witnessmenow/ESP32-Trinity/hardware/Add-Ons/Matrix Logic Level Shifter/README.md

An external add-on for logic level shifting the pins from the ESP32 to the Matrix. It is not Trinity specific and could be used with any matrix solution.

Potential solution for https://github.com/witnessmenow/ESP32-Trinity/issues/4
