witnessmenow/ESP32-Trinity/hardware/ESP32Trinity/V2.0 - Unreleased 4 layer version/README.md

**Untested!!**

This version is a 4 layer board that includes logic level shifters. I have ordered a PCB, but I have never actually assembled it so I'm unsure if it works.
