witnessmenow/ESP32-Trinity/userProjects.md

# User Projects

Made something with the Trinity? Why don't you share it here! Feel free to push a PR with your project added to this page, please just follow the template of the other projects.

## clockwise - By Jonathas Barbosa

Clockwise is a platform for creating animations with awesome clock animations

Mario jumping against coin block to change the time

The project is written with platform.io, so will require some experience with that to get it to run. Jonathas is working on a simpler version that uses the Arduino IDE so keep an eye out!

[Github](https://github.com/jnthas/clockwise)
