witnessmenow/ESP32-Trinity/documentation/Large Details Card/1.png

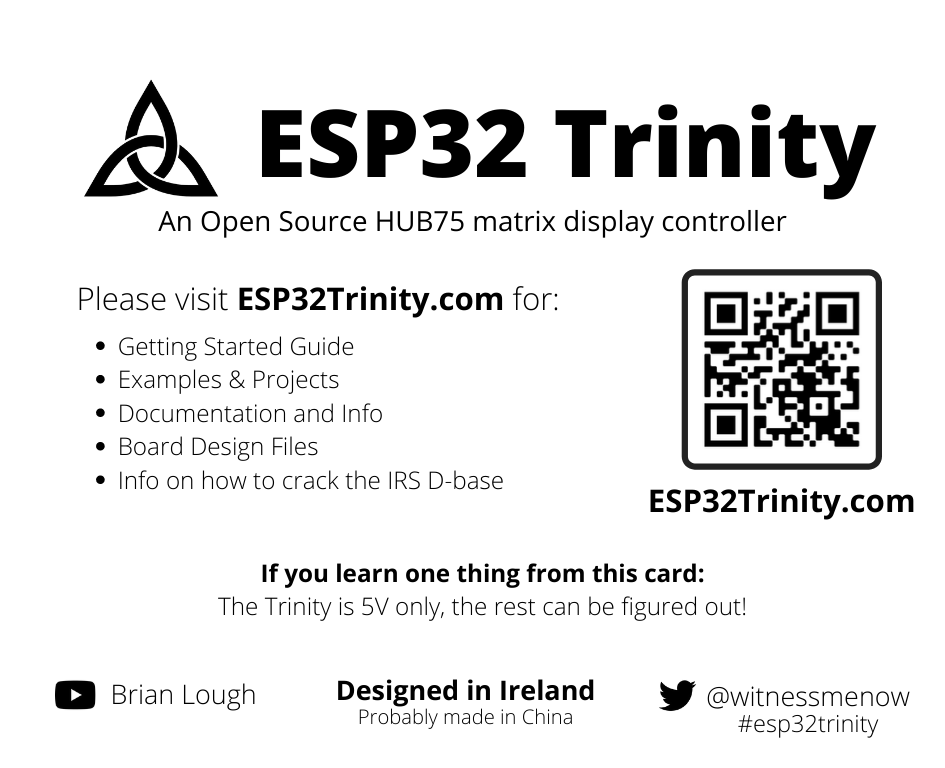
documentation/Large Details Card/1.png
