witnessmenow/ESP32-Trinity/documentation/Large Details Card/2.png

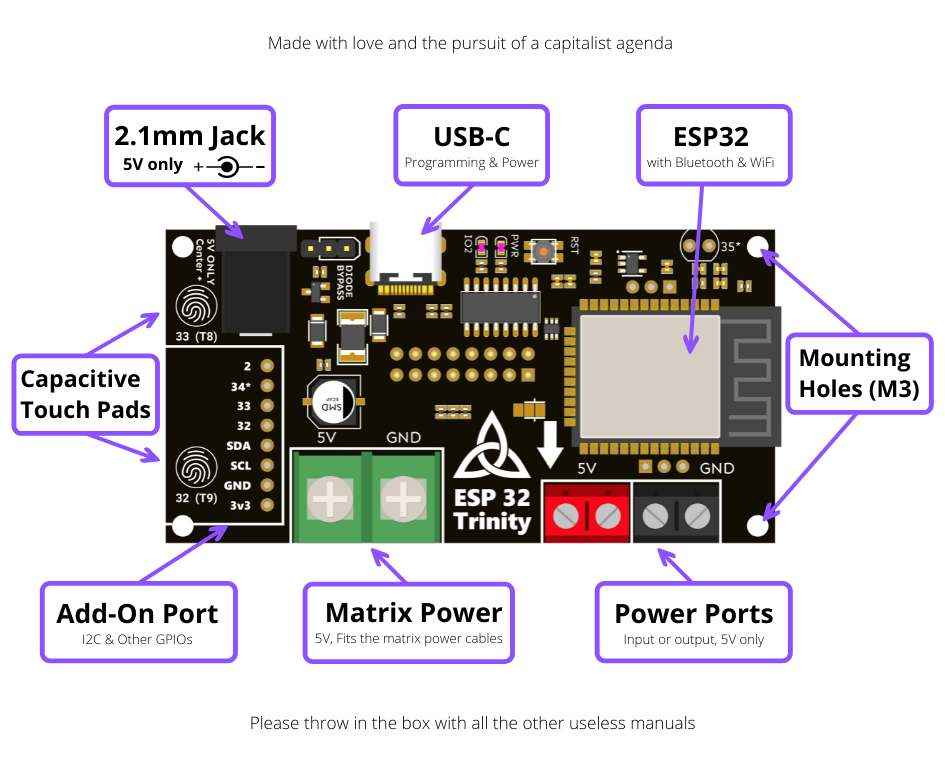
documentation/Large Details Card/2.png
