witnessmenow/ESP32-Trinity/documentation/Small Details Card/1.png

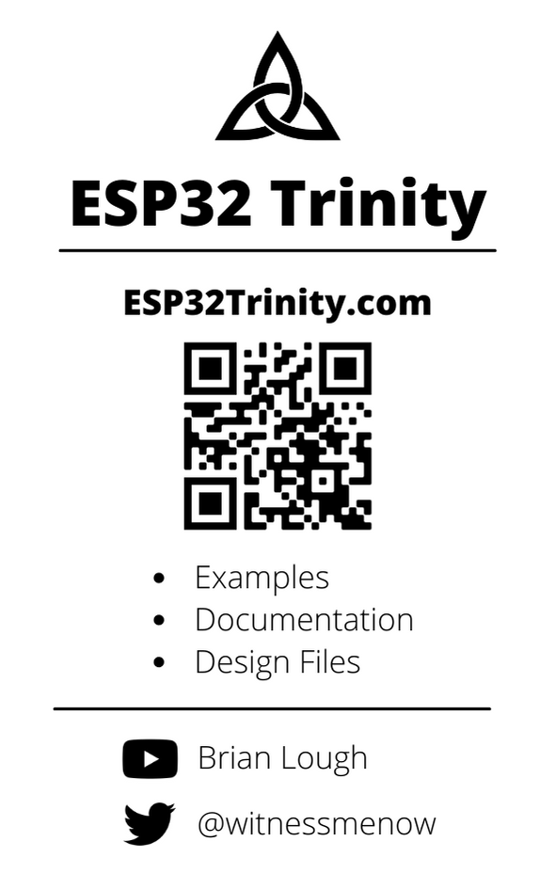
documentation/Small Details Card/1.png
