witnessmenow/ESP32-Trinity/documentation/Small Details Card/2.png

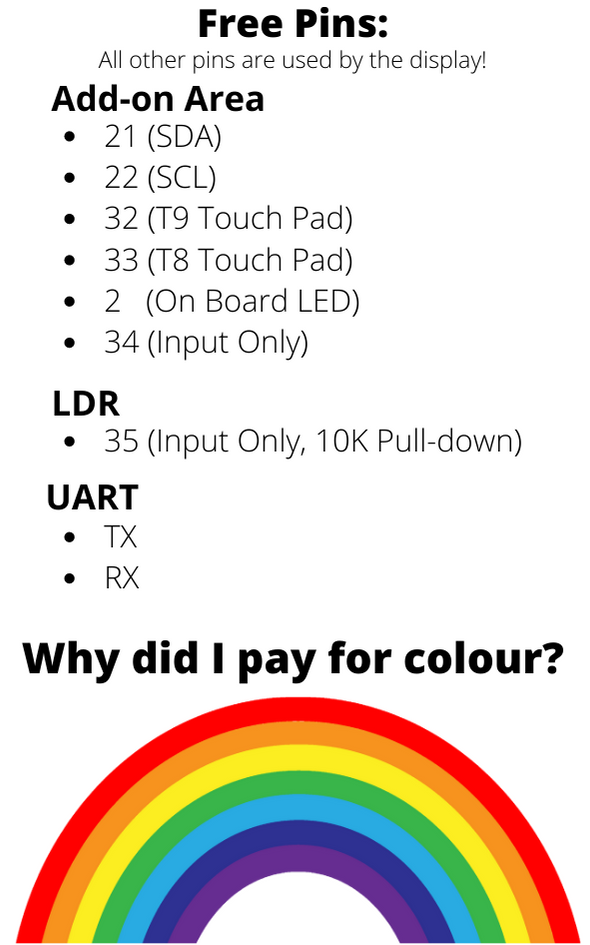
documentation/Small Details Card/2.png
