witnessmenow/ESP32-Trinity/hardware/Add-Ons/Add-on-Breakout/Schematic_Trinity Add-On-Breakout_2021-09-19.png

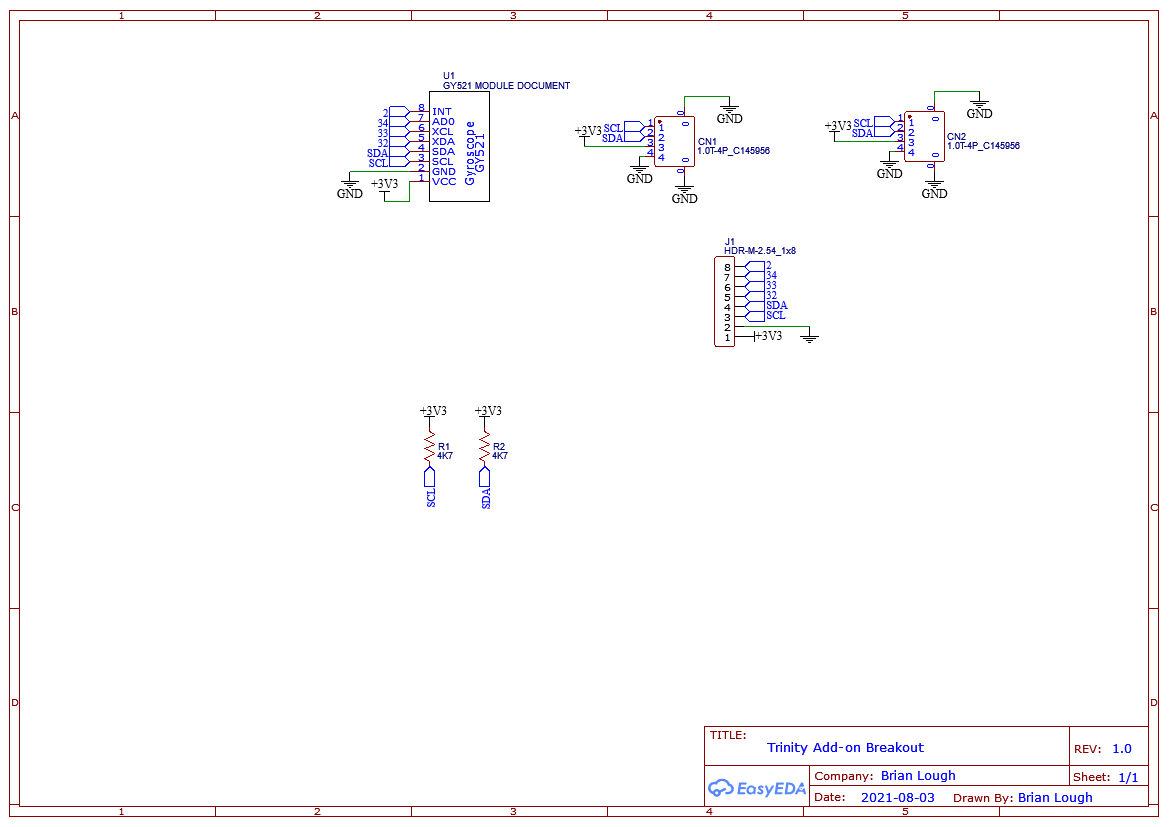
hardware/Add-Ons/Add-on-Breakout/Schematic_Trinity Add-On-Breakout_2021-09-19.png
