witnessmenow/ESP32-Trinity/hardware/Add-Ons/Matrix Logic Level Shifter/V1.0/Schematic_Hub75-Level-shifter_2024-02-03.png

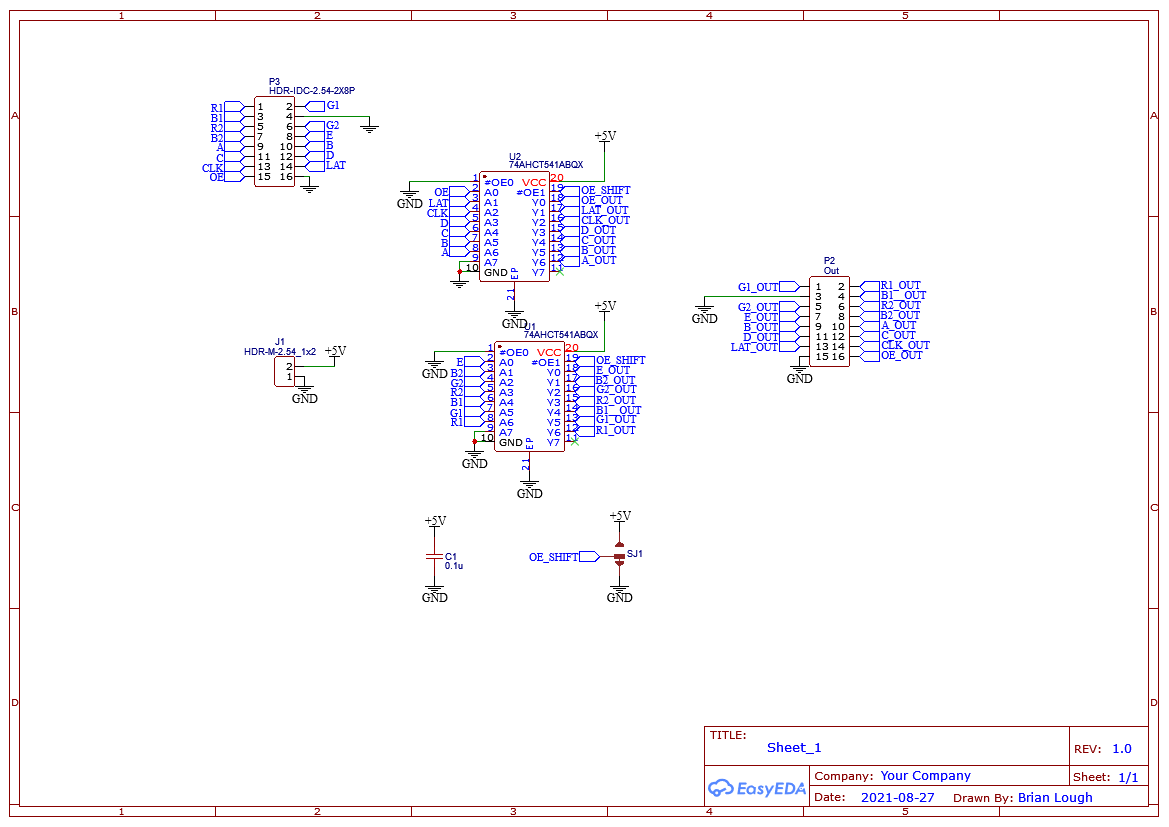
hardware/Add-Ons/Matrix Logic Level Shifter/V1.0/Schematic_Hub75-Level-shifter_2024-02-03.png
