witnessmenow/ESP32-Trinity/hardware/Add-Ons/MicroSd-board/Schematic_SD Card GY521_2021-09-19.png

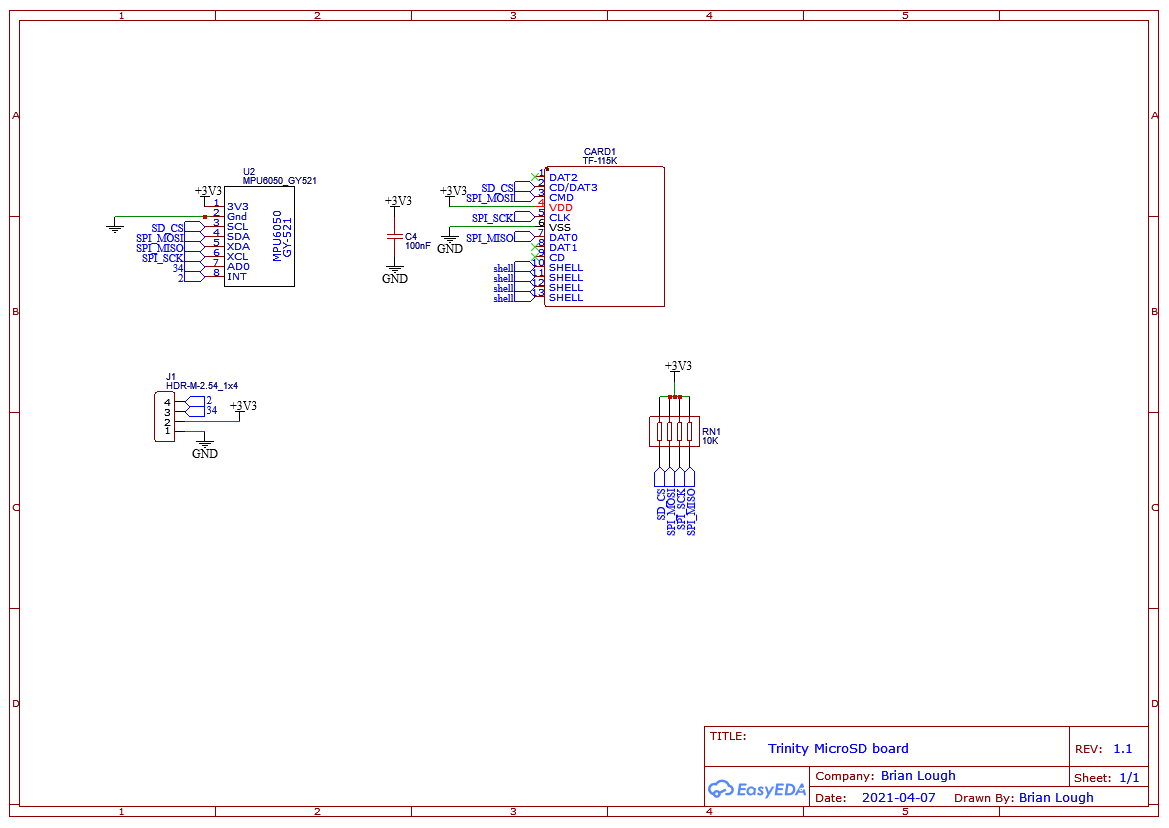
hardware/Add-Ons/MicroSd-board/Schematic_SD Card GY521_2021-09-19.png
