witnessmenow/ESP32-Trinity/hardware/Add-Ons/Nunchuck-board/Schematic_Nunchuck-MPU6050_2021-09-19.png

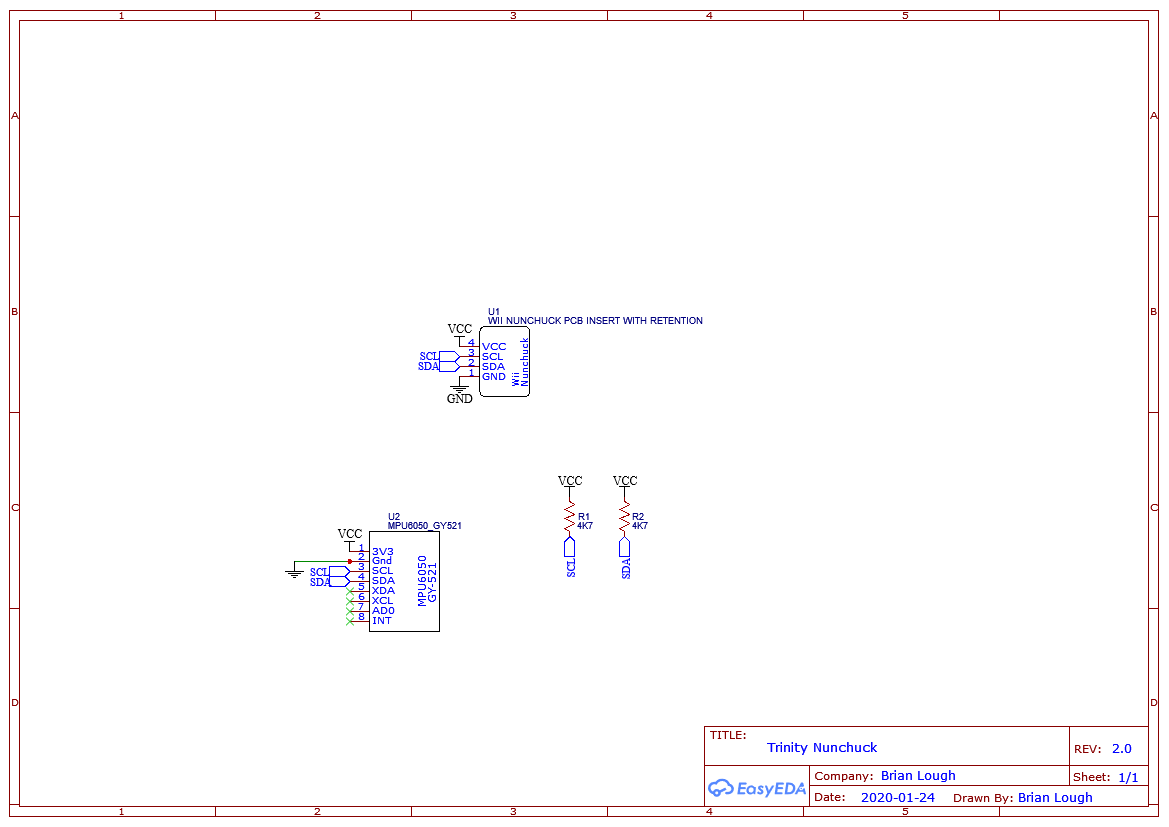
hardware/Add-Ons/Nunchuck-board/Schematic_Nunchuck-MPU6050_2021-09-19.png
