witnessmenow/ESP32-Trinity/hardware/ESP32Trinity/V1.2/Schematic_ESP32-Trinity_2021-08-27.png

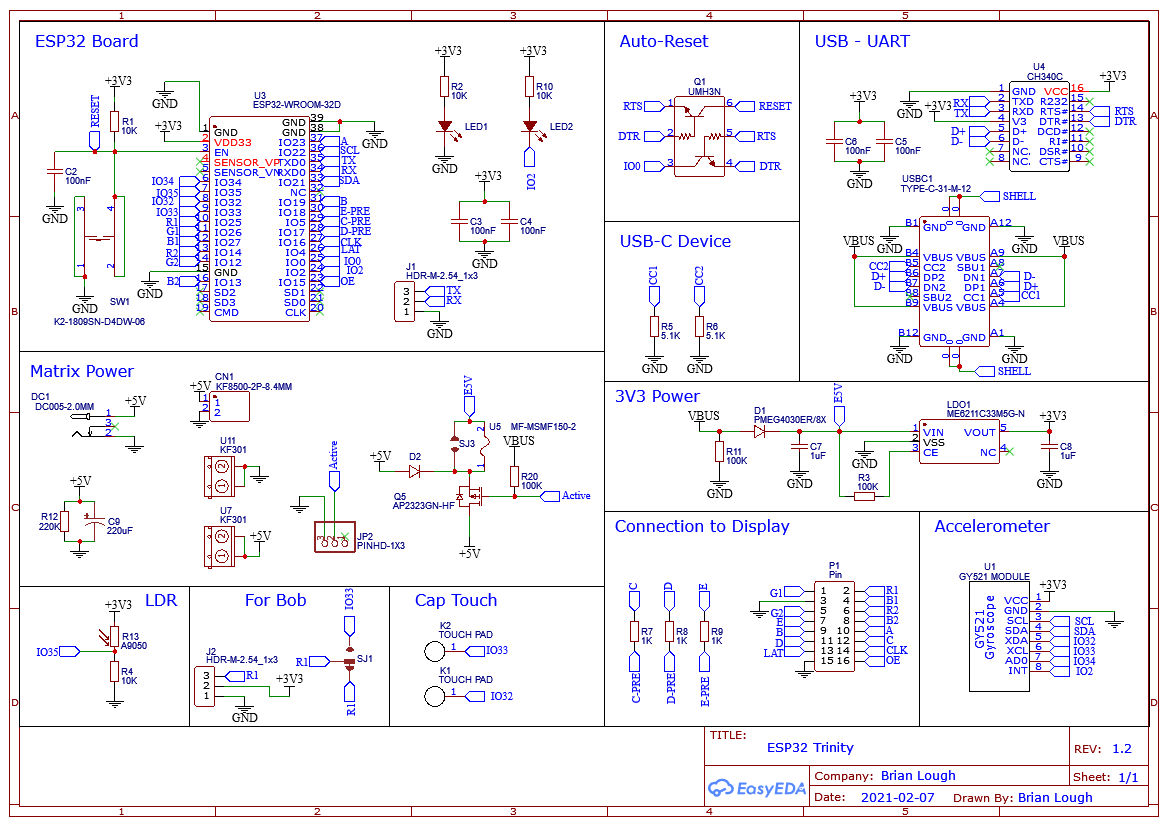
hardware/ESP32Trinity/V1.2/Schematic_ESP32-Trinity_2021-08-27.png
