witnessmenow/ESP32-Trinity/hardware/ESP32Trinity/V2.0 - Unreleased 4 layer version/Schematic_ESP32-Trinity_2024-02-03.png

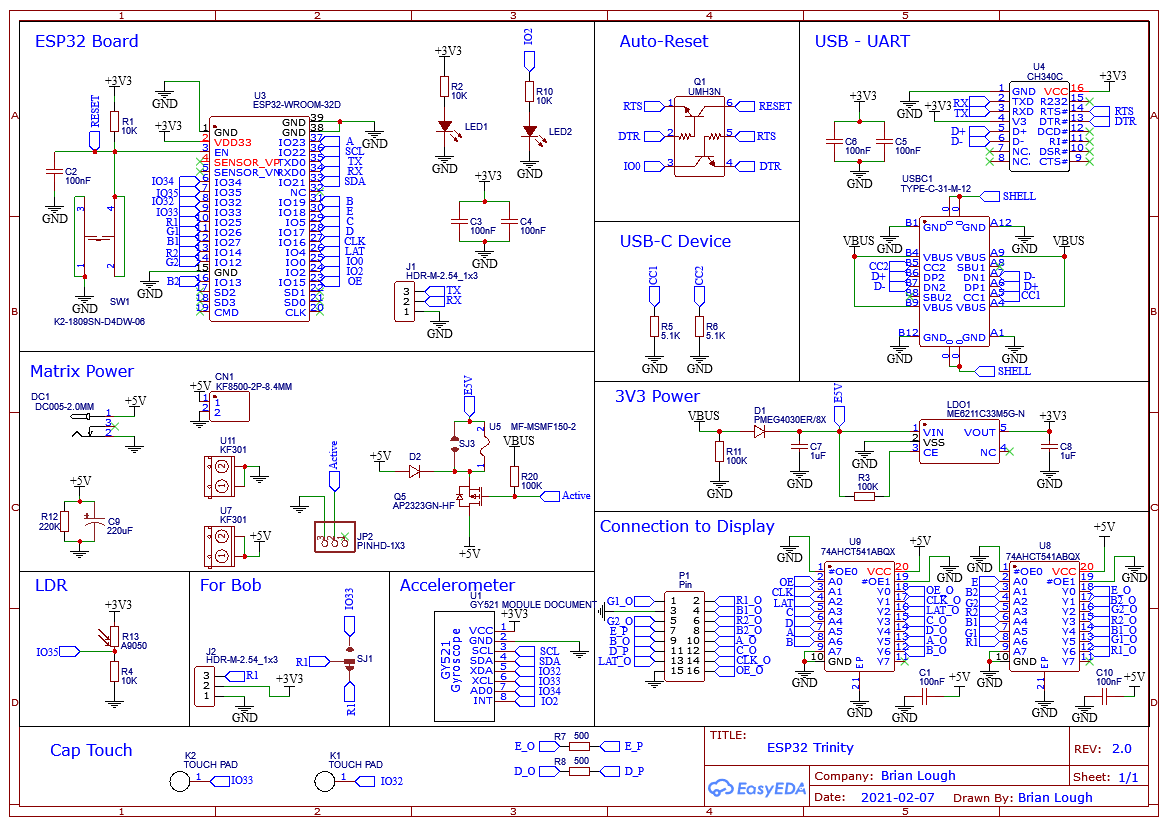
hardware/ESP32Trinity/V2.0 - Unreleased 4 layer version/Schematic_ESP32-Trinity_2024-02-03.png
