witnessmenow/ESP32-Trinity/images/IMG_20210925_105910.jpg

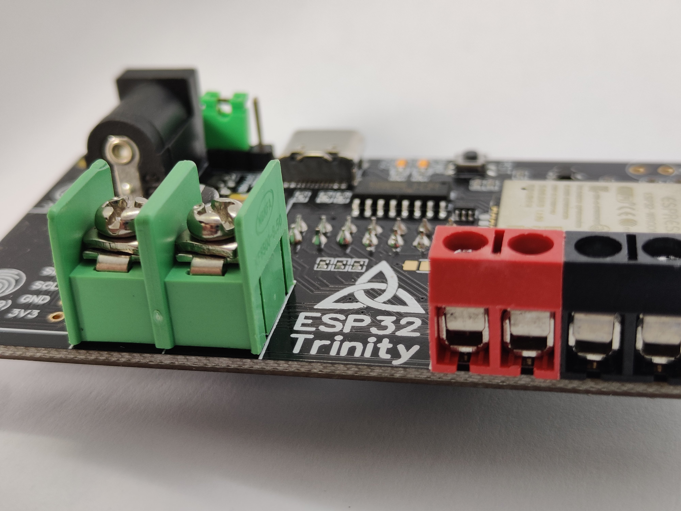
images/IMG_20210925_105910.jpg
