witnessmenow/ESP32-Trinity/images/IMG_20210925_105923.jpg

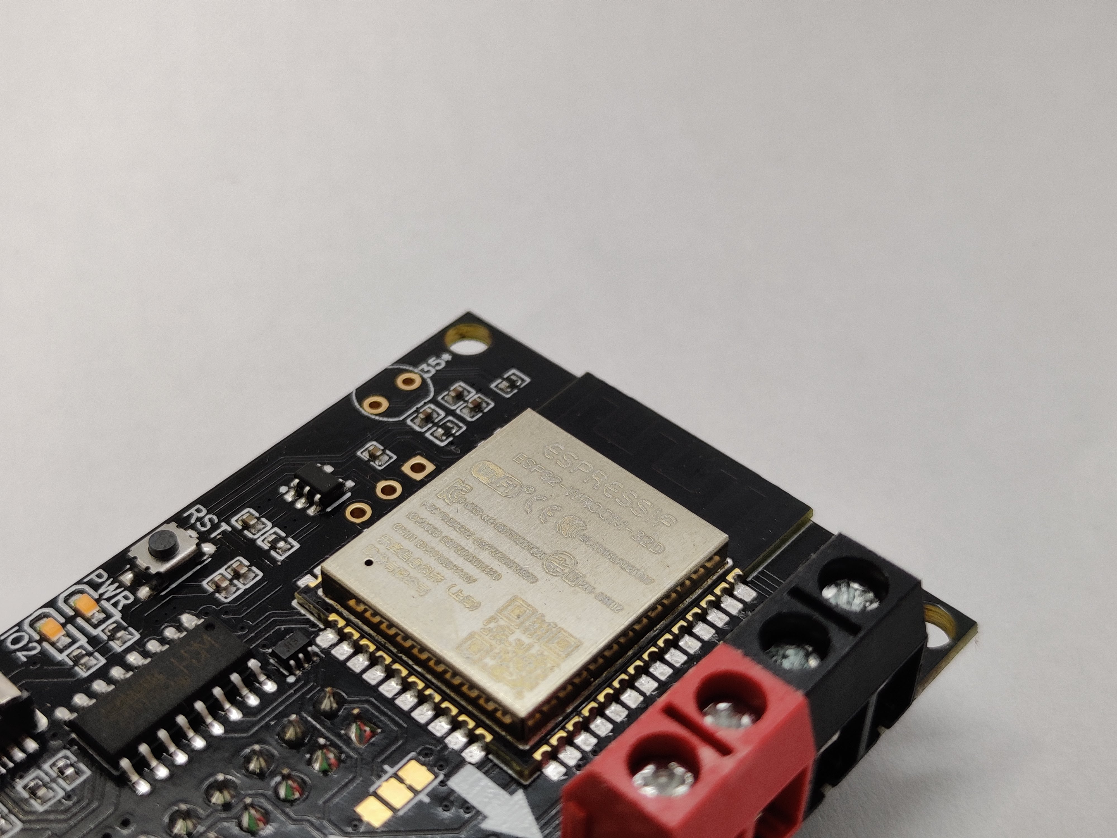
images/IMG_20210925_105923.jpg
