witnessmenow/ESP32-Trinity/images/IMG_20210925_110000.jpg

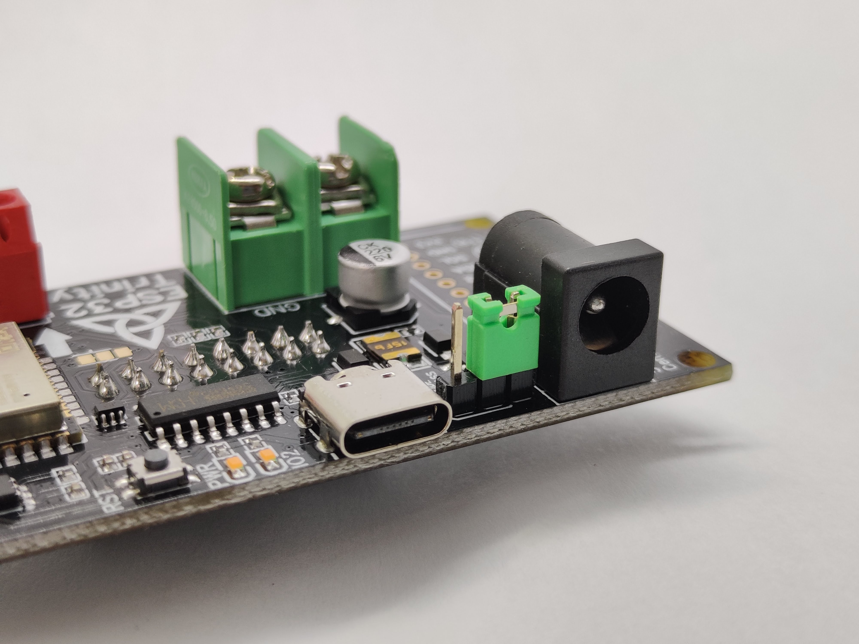
images/IMG_20210925_110000.jpg
