witnessmenow/ESP32-Trinity/images/IMG_20210925_110022.jpg

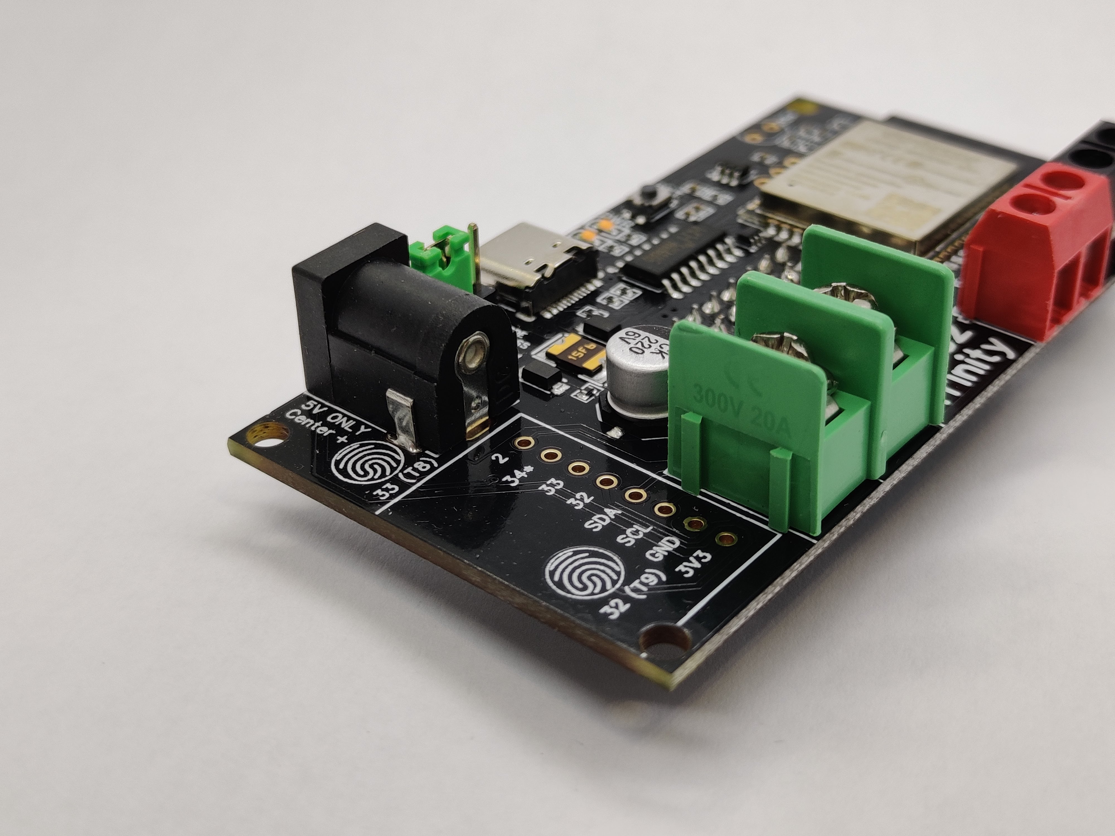
images/IMG_20210925_110022.jpg
