witnessmenow/ESP32-Trinity/images/IMG_20210925_110518.jpg

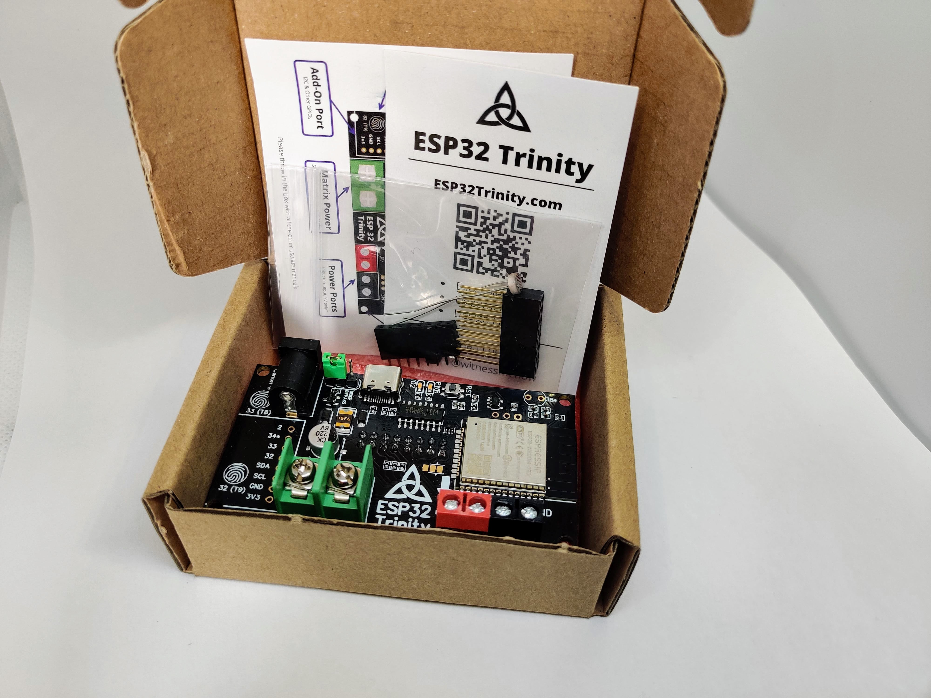
images/IMG_20210925_110518.jpg
