witnessmenow/ESP32-Trinity/images/P1000168.jpg

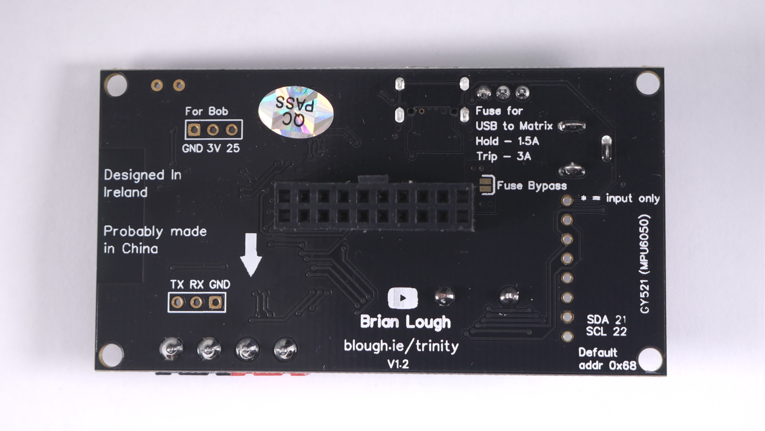
images/P1000168.jpg
