witnessmenow/ESP32-Trinity/images/trinity-2d.png

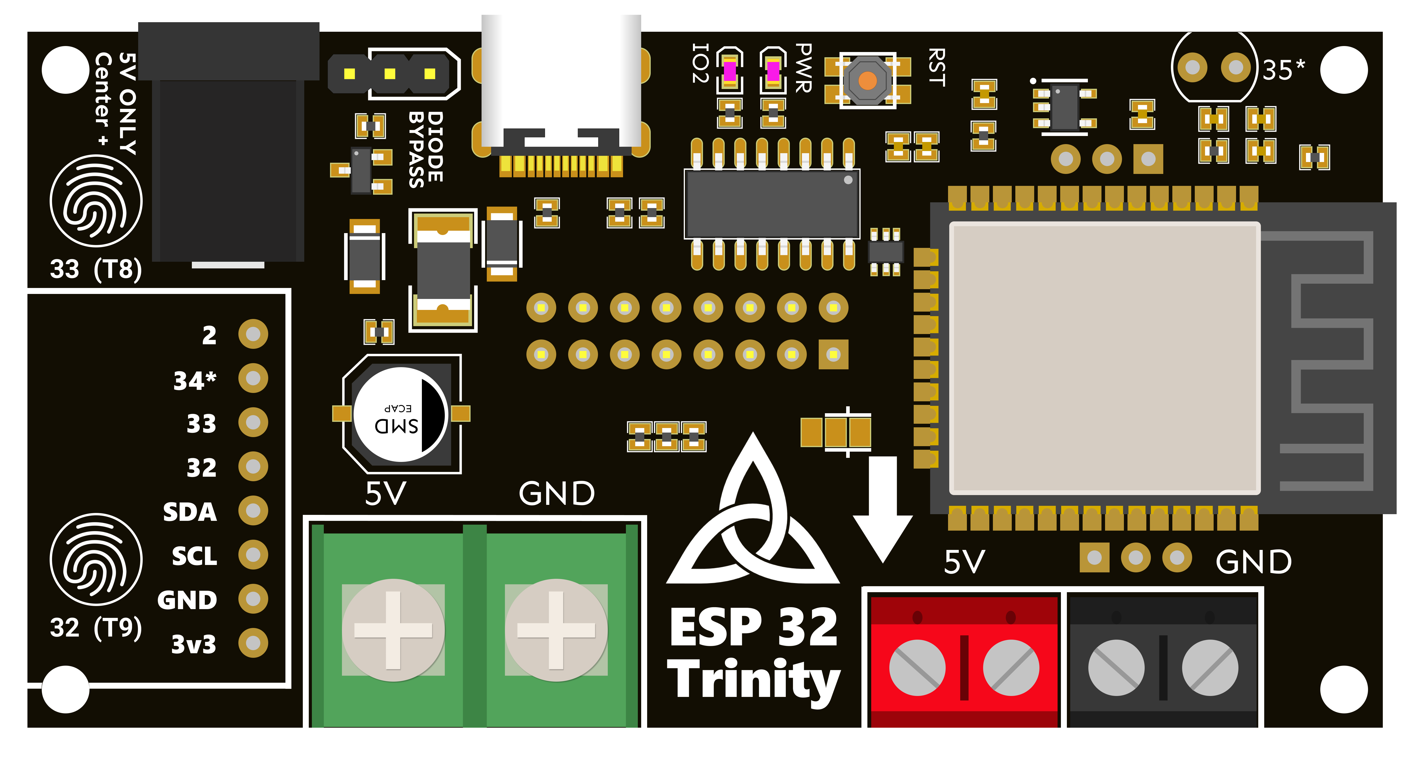
images/trinity-2d.png
