witnessmenow/ESP32-Trinity/hardware/ESP32Trinity/V2.0 - Unreleased 4 layer version/BOM_ESP32-Trinity_2024-02-03.csv

ID | Name | Designator | Footprint | Quantity | Manufacturer Part | Manufacturer | Supplier | Supplier Part | Price
1 | JUMPER-PAD-3-2OF3_NC_BY_TRACE_LARGE Spread | SJ1 | PAD-JUMPER-3-2OF3_NC_BY_TRACE_YES_SILK_LARGE_BRIAN | 1
2 | HDR-M-2.54_1x3 | J2,J1 | HDR-M-2.54_1X3 | 2 |  |  | LCSC | C180248 | 0.191
3 | JUMPER-PAD-2-NO Spread | SJ3 | PAD-JUMPER-2-NO_NO_SILK_NO_PASTE | 1
4 | Pin | P1 | HDR-8X2/2.54 | 1 | 2.54mm,2×8Double female header | BOOMELE | LCSC | C30734 | 0.118
5 | 500 | R7,R8 | R0402 | 2 | RC0402JR-07100KL | YAGEO | LCSC | C106234 | 0.001
6 | ESP32-WROOM-32D | U3 | WIFIM-SMD_39P-L25.5-W18.0-P1.27-BL | 1 | ESP32-WROOM-32D | ESPRESSIF 乐鑫 | LCSC | C473012 | 2.959
7 | 100nF | C1,C2,C3,C4,C5,C6,C10 | C0402 | 7 | CC0402KRX7R7BB104 | YAGEO | LCSC | C60474 | 0.001
8 | GY521 MODULE DOCUMENT | U1 | MPU6050 GY521 TRINITY DOCUMENT | 1
9 | 74AHCT541ABQX | U8,U9 | DHVQFN20_L4.5-W2.5-P0.50-BL-EP | 2 | 74AHCT541ABQX | Nexperia | LCSC | C554673 | 1.157
10 | ME6211C33M5G-N | LDO1 | SOT-23-5_L3.0-W1.7-P0.95-LS2.8-BR | 1 | ME6211C33M5G-N | MICRONE | LCSC | C82942 | 0.048
11 | TJ-S1608SW6TGLC6B-A5 | LED1,LED2 | LED0603-R-RD | 2 | TJ-S1608SW6TGLC6B-A5 | TOGIALED | LCSC | C192317 | 0.022
12 | PMEG4030ER/8X | D1,D2 | SOD-123_L2.8-W1.8-LS3.7-RD | 2 | PMEG4030ER/8X | Nexperia | LCSC | C458147 | 0.19
13 | 10K | R2,R10,R4 | R0402 | 3 | RC0402JR-071KL | YAGEO | LCSC | C105637 | 0.001
14 | AP2323GN-HF | Q5 | SOT-23-3_L2.9-W1.3-P1.90-LS2.4-BR | 1 | AP2323GN-HF | Advanced Power Elec | LCSC | C380189 | 0.208
15 | MF-MSMF150-2 | U5 | F1812 | 1 | MF-MSMF150-2 | BOURNS | LCSC | C89648 | 0.049
16 | PINHD-1X3 | JP2 | 1X03 | 1 | ?
17 | 100K | R20 | R0402 | 1 | RC0402JR-071KL | YAGEO | LCSC | C105637 | 0.001
18 | A9050 | R13 | RESISTOR_LDR_5X4.1_RM3 | 1 | ?
19 | UMH3N | Q1 | SC-70-6_L2.2-W1.3-P0.65-LS2.1-BR | 1 | UMH3N | CJ | LCSC | C62892 | 0.048
20 | TYPE-C-31-M-12 | USBC1 | USB-C_SMD-TYPE-C-31-M-12 | 1 | TYPE-C-31-M-12 | Rectangular Connectors - Contacts | LCSC | C165948 | 0.167
21 | 10K | R1 | R0402 | 1 | RC0402JR-0710KL | YAGEO | LCSC | C60489 | 0.001
22 | 100K | R3,R11 | R0402 | 2 | RC0402JR-07100KL | YAGEO | LCSC | C106234 | 0.001
23 | CH340C | U4 | SOP-16_L10.0-W3.9-P1.27-LS6.0-BL | 1 | CH340C | WCH | LCSC | C84681 | 0.5
24 | KF8500-2P-8.4MM | CN1 | KF8500-2P-8.4MM | 1 | KF8500-2p-8.4MM | Boom Precision Elec | LCSC | C42860 | 0.123
25 | 1uF | C7,C8 | C0402 | 2 | CL05A105KQ5NNNC | SAMSUNG | LCSC | C107372 | 0.002
26 | K2-1809SN-D4DW-06 | SW1 | SMD-3.5X3.0X1.5 | 1 | K2-1809SN-D4DW-06 | HRO | LCSC | C128941 | 0.096
27 | 220K | R12 | R0402 | 1 | 0402WGF2203TCE | UniOhm | LCSC | C25767 | 0.001
28 | 220uF | C9 | CAP-SMD_BD6.3-L6.6-W6.6-FD | 1 | VT0J221M-CRE54 | Vertical Technology | LCSC | C305368 | 0.03
29 | DC005-2.0MM | DC1 | DC-5020 | 1 | DC005-2.0MM | SOFNG | LCSC | C111567 | 0.153
30 | KF301 | U7,U11 | KF301 | 2 | KF301
31 | 5.1K | R6,R5 | R0402 | 2 | RC0402JR-075K1L | YAGEO | LCSC | C105873 | 0.001
32 | TOUCH PAD | K2,K1 | TOUCH_PAD | 2 | Touch
