witnessmenow/ESP32-Trinity/hardware/Add-Ons/Add-on-Breakout/BOM_Trinity Add-On-Breakout_2021-09-19.csv

ID | Name | Designator | Footprint | Quantity | Manufacturer Part | Manufacturer | Supplier | Supplier Part | Price
1 | 1.0T-4P_C145956 | CN1,CN2 | CONN-SMD_1.0T-4P | 2 | - | Boom Precision Elec | LCSC | C145956 | 0.054
2 | HDR-M-2.54_1x8 | J1 | HDR-M-2.54_1X8 | 1 |  |  | LCSC | C190820 | 0.034
3 | 4K7 | R1,R2 | R0805 | 2 | I2C Pull-ups
