witnessmenow/ESP32-Trinity/hardware/Add-Ons/MicroSd-board/BOM_PCB_SD Card GY521_2021-07-08.csv

ID | Name | Designator | Footprint | Quantity | Manufacturer Part | Manufacturer | Supplier | Supplier Part
1 | 10K | RN1 | RES-ARRAY-SMD_0603-8P-L3.2-W1.6-BL | 1 | WA06X103JTL | Huaxin S&T | LCSC | C164037
2 | 100nF | C4 | C0402 | 1 | CC0402KRX7R7BB104 | YAGEO | LCSC | C60474
4 | TF-115K | CARD1 | TF-SMD_TF-115K | 1 | TF-115K | XUNPU | LCSC | C266621
