witnessmenow/ESP32-Trinity/hardware/Add-Ons/Nunchuck-board/BOM_Nunchuck-MPU6050_2021-09-19.csv

ID | Name | Designator | Footprint | Quantity | Manufacturer Part | Manufacturer | Supplier | Supplier Part | Price
1 | 4K7 | R1,R2 | R0805 | 2 | I2C Pull-ups
