witnessmenow/ESP32-Trinity/hardware/Add-Ons/Matrix Logic Level Shifter/V1.0/BOM_Hub75-Level-shifter_2024-02-03.csv

ID | Name | Designator | Footprint | Quantity | Manufacturer Part | Manufacturer | Supplier | Supplier Part | Price
1 | 0.1u | C1 | C0603 | 1
2 | Out | P2 | HDR-8X2/2.54 | 1 | 2.54mm,2×8Double female header | BOOMELE | LCSC | C30734 | 0.118
3 | HDR-M-2.54_1x2 | J1 | HDR-M-2.54_1X2 | 1 |  |  | LCSC | C124375 | 0.023
4 | HDR-IDC-2.54-2X8P | P3 | IDC-TH_16P-P2.54_C3406 | 1 | IDC Box 2.54mm 16P Straight | BOOMELE | LCSC | C3406 | 0.092
5 | JUMPER-PAD-3-2OF3_NC_BY_TRACE_LARGE Spread | SJ1 | PAD-JUMPER-3-2OF3_NC_BY_TRACE_YES_SILK_LARGE_BRIAN | 1
6 | 74AHCT541ABQX | U1,U2 | DHVQFN20_L4.5-W2.5-P0.50-BL-EP | 2 | 74AHCT541ABQX | Nexperia | LCSC | C554673 | 1.157
