witnessmenow/ESP32-Trinity/(threads)

Thread 1 (2021-09-21):

+5v position <>  before Diode or after Diode

Kamal-Sonani, 2021-09-21:
what if I give reverse polarity to board? as per design I think +5v firstly pass through Diode(D2)

& if not ,Capacitor will Blast but rest of circuit remain.
Correct me 🧐 with logic.

waiting for final release.

witnessmenow, 2021-09-21:
Potentially, the purpose of D2 is to allow the barrel jack to power the esp32 side of the circuit, while providing a stop for the USB from powering the matrix panel unless the user specifically configures for that using the jumper pins.

If you have a project that uses 2A on the panel and you want to program it with USB, there needs to be a way to power the esp32 while not powering the panel.

There is no reverse polarity protection in this version of the design.

witnessmenow, 2021-09-22:
I'm going to close this as I don't feel like there is any action to be taken on it at the moment

Closed 2021-09-22.

Thread 2 (2021-09-25):

Info cards slightly too big for box

witnessmenow, 2021-09-25:
It's OK for the first batch, but for batch 2 it should be addressed.

Either need to shave a couple of mm off the cards or get a bigger box

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

Thread 3 (2021-09-25):

No need for "QC Pass" stickers on units

witnessmenow, 2021-09-25:
The "QC Pass" stickers do not look great (and they are upside down 🙃 )

All Trinity sold by me & official resellers have been tested, so the "QC Pass" sticker is not needed

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

Thread 4 (2021-09-25):

Some Matrix panels when supplied with more than a 5V supply require level shifting.

witnessmenow, 2021-09-25:
This seems to be rare as I have only seen it on one panel out of the 10+ I have tested and I never seen any complaints about the I2S matrix shield (which is effectively the same as the Trinity) having this problem but during testing of the Trinity Makerfabs found a 64x64 panel that had issues when using a power supply that provided more than 5V

Even if the power supply is rated for 5V, some supplies, especially cheaper ones, will combat against voltage drop by providing more than 5V.

For most displays this is not an issue, I have tested displays here all the way up to 5.6V without any issue, but this one display that Makerfabs had (and now I have) seems to deteriorate if the supply voltage is larger than roughly 5.2V. The display works fine with lower voltages than this so presumably it is not actually a defective panel.

For this problem panel USB-C seems to work well with them as USB goes through the reverse feedback protection diode which will bring down the voltage below the problem voltage range.

To combat these panels being a problem in the future, the next revision of the Trinity will include level shifters from 3.3V of the ESP32 to whatever VCC is of the Matrix panel. I have tested using two 74AHCT541ABQX for the level shifting (as they are compact) and they seem to be working well

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

I can make the design available if people want them, but they are kind of difficult to assemble (the level shifters can't be hand soldered)

One challenge of adding the level shifters is it will be no longer possible to use a 2 layer board for the Trinity and we will have to move to a 4 layer, which is something new to me. I have the majority of a 4 layer design made up, but I have not even ordered a trial yet never mind being in a position to swap over to this version for production.

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

lols, 2022-09-27:
You can try to use 0ohm resistor to jump pass trace to continue to use 2 layer pcb, not pretty, but gets the job done and is cheaper than 4 layer
But as usual try not to jump unless really no way to route pass a trace

witnessmenow, 2024-02-03:
Added files for the V2 Trinity (which are **untested!**) and the external level shifter to the Hardware section

Thread 13 (2022-01-28):

Colon not blinking in between minutes

donnersm, 2022-01-28:
I tried the sketch for the testis clock with WIFImanager.
I used the original code but I changed the display interface to work on my hardwire with different pin setup.
All is working except the colon. Whenever an animation is active the 2 dots are blinking at 1 sec interval but whenever the animation of a number( or letter) is done, the colon freezes in whatever state it was in last. sometime's it stays black, sometimes it stays white but doesn't blink. Blinking is resumed when next animation starts.

I changed Matrix config to:
```
// -------------------------------------
// -------   Matrix Config   ------
// -------------------------------------

#define PANEL_RES_X 64      // Number of pixels wide of each INDIVIDUAL panel module.
#define PANEL_RES_Y 64     // Number of pixels tall of each INDIVIDUAL panel module.
#define PANEL_CHAIN 2      // Total number of panels chained one to another
#define A_PIN         23
#define B_PIN         19
#define C_PIN         5
#define D_PIN         17
#define E_PIN         22
#define LAT_PIN       18
#define OE_PIN        15
#define CLK_PIN       16
#define R1_PIN        33
#define B2_PIN        13
#define R2_PIN        14
#define G2_PIN        12

https://user-images.githubusercontent.com/60584210/151605967-a93c3f68-ac49-4284-8ad0-7fcd37576fef.mp4

#define G1_PIN        26
#define B1_PIN        27
// -------------------------------------
```
And I added /changed it near line 373 to fit my hardware:

`// -------------------------------------
// -------   Matrix Config   ------
// -------------------------------------

#define PANEL_RES_X 64      // Number of pixels wide of each INDIVIDUAL panel module.
#define PANEL_RES_Y 64     // Number of pixels tall of each INDIVIDUAL panel module.
#define PANEL_CHAIN 2      // Total number of panels chained one to another
#define A_PIN         23
#define B_PIN         19
#define C_PIN         5
#define D_PIN         17
#define E_PIN         22
#define LAT_PIN       18
#define OE_PIN        15
#define CLK_PIN       16
#define R1_PIN        33
#define B2_PIN        13
#define R2_PIN        14
#define G2_PIN        12
#define G1_PIN        26
#define B1_PIN        27
// -------------------------------------`

witnessmenow, 2022-01-28:
Thanks for the video, it must be a problem with the code for the 12 hour
clock cause the 24 hour clock works fine.

Will dig into over the weekend!

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

donnersm, 2022-01-28:
I tried the 24 hour clock by adjusting the config in the wifi manager....result is the same. The 24 hour clock has same effect. colon not blinking.
I can make a video but it looks just the same except it's a 24hour clock lol

witnessmenow, 2022-01-29:
What code version is it? Is this the version with wifi manager?

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

donnersm, 2022-01-29:
Yes it's the version with wifi manger. I used the link you send me on discord and clicked the wifi manager version

donnersm, 2022-01-30:
Hi brian,
I just uploaded the non wifimanager version and it has the same behaviour

donnersm, 2022-01-30:
Found a workaround....is not optimal but it might help you diagnose.
I included the fastled libary:
#include <FastLED_NeoMatrix.h>
as a quick and dirty import of one specific function:
EVERY_N_MILLISECONDS(1000)

So I added this line before the closing bracket of the loop
EVERY_N_MILLISECONDS(1000) {handleColonAfterAnimation();};

Now all is working fine.
For some reason the
if (finishedAnimating) {
      handleColonAfterAnimation();
    }
loop doesn't do the handleColonAfterAnimation(); the loop itself is entered ( i added a line of text output to serial port to monitor)

Hope that helps

donnersm, 2022-04-02:
Did some more digging ....this only happens with the doublebuffer on ( display)  looks like when it happens, it writes to the other buffer...anyway...due to memory limitations i stick to a single buffer for now. With double buffer disables..all workes fine

ddavehauser, 2022-11-12:
Hi, im currently having the same issue as well.

are there any fixes except the fastled workaround yet?

Thanks!

Thread 14 (2022-08-06):

Cannot use latest (2.0.7) ESP32-HUB75-MatrixPanel-I2S-DMA library

mdskier, 2022-08-06:
Trying to use This project:
https://github.com/witnessmenow/ESP32-Trinity/blob/master/examples/BuildingBlocks/Text/ScrollingText/ScrollingText.ino
will not compile with 2.0.7 (or 2.0.6). Using version 2.0.5 of that library does work, however.
Get the following error:
/Users/tom/Arduino/libraries/ESP32_HUB75_LED_MATRIX_PANEL_DMA_Display/ESP32-HUB75-MatrixPanel-I2S-DMA.cpp:10:21: note: #pragma message: Compiling for original (released 2016) 520kB SRAM ESP32.
     #pragma message "Compiling for original (released 2016) 520kB SRAM ESP32."
                     ^~~~~~~~~~~~~~~~~~~~~~~~~~~~~~~~~~~~~~~~~~~~~~~~~~~~~~~~~~
sketch/ScrollingSignTime.ino.cpp.o: in function `MatrixPanel_I2S_DMA::flipDMABuffer()':
/Users/tom/Arduino/libraries/ESP32_HUB75_LED_MATRIX_PANEL_DMA_Display/ESP32-HUB75-MatrixPanel-I2S-DMA.h:528:(.iram1.29[MatrixPanel_I2S_DMA::flipDMABuffer()]+0x8): dangerous relocation: l32r: literal placed after use: .literal._ZN19MatrixPanel_I2S_DMA13flipDMABufferEv
/Users/tom/Arduino/libraries/ESP32_HUB75_LED_MATRIX_PANEL_DMA_Display/ESP32-HUB75-MatrixPanel-I2S-DMA.h:530:(.iram1.29[MatrixPanel_I2S_DMA::flipDMABuffer()]+0xe): dangerous relocation: l32r: literal placed after use: (.literal._ZN19MatrixPanel_I2S_DMA13flipDMABufferEv+0x4)
/Users/tom/Arduino/libraries/ESP32_HUB75_LED_MATRIX_PANEL_DMA_Display/ESP32-HUB75-MatrixPanel-I2S-DMA.h:532:(.iram1.29[MatrixPanel_I2S_DMA::flipDMABuffer()]+0x1c): dangerous relocation: l32r: literal placed after use: (.literal._ZN19MatrixPanel_I2S_DMA13flipDMABufferEv+0x8)
/Users/tom/Arduino/libraries/ESP32_HUB75_LED_MATRIX_PANEL_DMA_Display/ESP32-HUB75-MatrixPanel-I2S-DMA.h:537:(.iram1.29[MatrixPanel_I2S_DMA::flipDMABuffer()]+0x2e): dangerous relocation: l32r: literal placed after use: (.literal._ZN19MatrixPanel_I2S_DMA13flipDMABufferEv+0xc)
Multiple libraries were found for "WiFi.h"
 Used: /Users/tom/Library/Arduino15/packages/esp32/hardware/esp32/2.0.4/libraries/WiFi
 Not used: /Applications/Arduino.app/Contents/Java/libraries/WiFi
/Users/tom/Arduino/libraries/ESP32_HUB75_LED_MATRIX_PANEL_DMA_Display/ESP32-HUB75-MatrixPanel-I2S-DMA.h:539:(.iram1.29[MatrixPanel_I2S_DMA::flipDMABuffer()]+0x34): dangerous relocation: l32r: literal placed after use: (.literal._ZN19MatrixPanel_I2S_DMA13flipDMABufferEv+0x10)
collect2: error: ld returned 1 exit status
exit status 1
Error compiling for board WEMOS D1 MINI ESP32.

Thread 16 (2022-11-12):

Trinity ESP32 pin numbers used?

tychop, 2022-11-12:
What are the pin numbers used on the trinity board for these #define's ?

A_PIN
B_PIN
C_PIN
D_PIN
E_PIN
LAT_PIN
OE_PIN
CLK_PIN
R1_PIN
B2_PIN
R2_PIN
G2_PIN
G1_PIN
B1_PIN

tychop, 2022-11-12:
Found them...

#define R1_PIN_DEFAULT  25
#define G1_PIN_DEFAULT  26
#define B1_PIN_DEFAULT  27
#define R2_PIN_DEFAULT  14
#define G2_PIN_DEFAULT  12
#define B2_PIN_DEFAULT  13

#define A_PIN_DEFAULT   23
#define B_PIN_DEFAULT   19
#define C_PIN_DEFAULT   5
#define D_PIN_DEFAULT   17
#define E_PIN_DEFAULT   18 // This is the only change from the default pins of the library

#define LAT_PIN_DEFAULT 4
#define OE_PIN_DEFAULT  15

#define CLK_PIN_DEFAULT 16

Closed 2022-11-12.

Thread 18 (2023-01-19):

Ever use WLED?

mermelmadness, 2023-01-19:
I tried asking this question on the Discord but didn't get a response.  Have you ever tried flashing WLED to your ESP32 Trinity board and have it control a HUB75 matrix?  If yes, were there any special roadblocks you had to overcome?

jangrewe, 2023-05-27:
WLED is for  WS2812B-compatible LED strips, not these kind of matrixes.

mermelmadness, 2023-05-28:
Actually, you can make it control HUB75 matrices using a different intermediary board.

Closed 2023-05-28.

Thread 19 (2023-02-07):

Error in DisplayImageFromWeb

lohant, 2023-02-07:
I get the following error when trying to run the DisplayImageFromWeb example on my ESP32 Trinity:

In file included from /Users/a/Documents/Arduino/libraries/ESP32-HUB75-MatrixPanel-DMA-master/src/ESP32-HUB75-MatrixPanel-I2S-DMA.h:12,
                 from /Users/a/Documents/Arduino/DisplayImageFromWeb/DisplayImageFromWeb.ino:41:
/Users/a/Documents/Arduino/libraries/ESP32-HUB75-MatrixPanel-DMA-master/src/platforms/platform_detect.hpp:58:19: note: #pragma message: Compiling for original ESP32 (released 2016)
   #pragma message "Compiling for original ESP32 (released 2016)"
                   ^~~~~~~~~~~~~~~~~~~~~~~~~~~~~~~~~~~~~~~~~~~~~~
In file included from /Users/a/Documents/Arduino/DisplayImageFromWeb/DisplayImageFromWeb.ino:47:
/Users/a/Documents/Arduino/libraries/JPEGDEC/src/JPEGDEC.h:214:14: error: 'File' has not been declared
     int open(File &file, JPEG_DRAW_CALLBACK *pfnDraw);
              ^~~~
/Users/a/Documents/Arduino/DisplayImageFromWeb/DisplayImageFromWeb.ino: In function 'void drawImageFile(char*)':
/Users/a/Documents/Arduino/DisplayImageFromWeb/DisplayImageFromWeb.ino:216:60: error: invalid conversion from 'void (*)(JPEGDRAW*)' {aka 'void (*)(jpeg_draw_tag*)'} to 'int (*)(JPEGDRAW*)' {aka 'int (*)(jpeg_draw_tag*)'} [-fpermissive]
   jpeg.open(imageFileUri, myOpen, myClose, myRead, mySeek, JPEGDraw);
                                                            ^~~~~~~~
In file included from /Users/a/Documents/Arduino/DisplayImageFromWeb/DisplayImageFromWeb.ino:47:
/Users/a/Documents/Arduino/libraries/JPEGDEC/src/JPEGDEC.h:212:176: note:   initializing argument 6 of 'int JPEGDEC::open(const char*, void* (*)(const char*, int32_t*), void (*)(void*), int32_t (*)(JPEGFILE*, uint8_t*, int32_t), int32_t (*)(JPEGFILE*, int32_t), int (*)(JPEGDRAW*))'
     int open(const char *szFilename, JPEG_OPEN_CALLBACK *pfnOpen, JPEG_CLOSE_CALLBACK *pfnClose, JPEG_READ_CALLBACK *pfnRead, JPEG_SEEK_CALLBACK *pfnSeek, JPEG_DRAW_CALLBACK *pfnDraw);
                                                                                                                                                            ~~~~~~~~~~~~~~~~~~~~^~~~~~~

exit status 1

Compilation error: invalid conversion from 'void (*)(JPEGDRAW*)' {aka 'void (*)(jpeg_draw_tag*)'} to 'int (*)(JPEGDRAW*)' {aka 'int (*)(jpeg_draw_tag*)'} [-fpermissive]

My code looks like this:
`
// ----------------------------
// Standard Libraries
// ----------------------------

#include <WiFi.h>
#include <WiFiClientSecure.h>

#define FS_NO_GLOBALS
#include <FS.h>
#include "SPIFFS.h"

// ----------------------------
// Additional Libraries - each one of these will need to be installed.
// ----------------------------

#include <ESP32-HUB75-MatrixPanel-I2S-DMA.h>
// This is the library for interfacing with the display

// Can be installed from the library manager (Search for "ESP32 MATRIX DMA")
// https://github.com/mrfaptastic/ESP32-HUB75-MatrixPanel-I2S-DMA

#include <JPEGDEC.h>
// Library for decoding Jpegs from the API responses

// Search for "JPEGDEC" in the Arduino Library manager
// https://github.com/bitbank2/JPEGDEC/

// ----------------------------
// Dependency Libraries - each one of these will need to be installed.
// ----------------------------

// Adafruit GFX library is a dependency for the matrix Library
// Can be installed from the library manager
// https://github.com/adafruit/Adafruit-GFX-Library

// ----------------------------
// Include Other Tabs
// ----------------------------

#include "WebRequest.h"

// -------------------------------------
// -------   Matrix Config   ------
// -------------------------------------

const int panelResX = 64;      // Number of pixels wide of each INDIVIDUAL panel module.
const int panelResY = 64;     // Number of pixels tall of each INDIVIDUAL panel module.
const int panel_chain = 1;      // Total number of panels chained one to another

// See the "displaySetup" method for more display config options

//------------------------------------------------------------------------------------------------------------------

// -------------------------------------
//------- Other Config - Replace the following! ------
// -------------------------------------

char ssid[] = "x";         // your network SSID (name)
char password[] = "x"; // your network password

// If you need to add a server cert for verifying the endpoint,
// Line 15 of web_fetch.h is where you would add it

//------- ---------------------- ------

// HTTPS image url
const char imageUrl[] = "https://i.imgur.com/1TBUEDE.jpg";

// Note the "/" at the start
const char imageLocation[] = "/img.jpg";

MatrixPanel_I2S_DMA *dma_display = nullptr;
JPEGDEC jpeg;
WiFiClientSecure client;

// This next function will be called during decoding of the jpeg file to
// render each block to the Matrix.  If you use a different display
// you will need to adapt this function to suit.
void JPEGDraw(JPEGDRAW *pDraw)
{
  // Stop further decoding as image is running off bottom of screen
  if (  pDraw->y >= dma_display->height() )return;

  dma_display->drawRGBBitmap(pDraw->x, pDraw->y, pDraw->pPixels, pDraw->iWidth, pDraw->iHeight);
}

void displaySetup() {
  HUB75_I2S_CFG mxconfig(
    panelResX,   // module width
    panelResY,   // module height
    panel_chain    // Chain length
  );

  // If you are using a 64x64 matrix you need to pass a value for the E pin
  // The trinity connects GPIO 18 to E.
  // This can be commented out for any smaller displays (but should work fine with it)
  mxconfig.gpio.e = 18;

  // May or may not be needed depending on your matrix
  // Example of what needing it looks like:
  // https://github.com/mrfaptastic/ESP32-HUB75-MatrixPanel-I2S-DMA/issues/134#issuecomment-866367216
  mxconfig.clkphase = false;

  // Some matrix panels use different ICs for driving them and some of them have strange quirks.
  // If the display is not working right, try this.
  //mxconfig.driver = HUB75_I2S_CFG::FM6126A;

  dma_display = new MatrixPanel_I2S_DMA(mxconfig);
  dma_display->begin();
}

void setup()
{
  Serial.begin(115200);

  displaySetup();

  dma_display->fillScreen(dma_display->color565(0, 0, 0));

  dma_display->setTextSize(1);     // size 1 == 8 pixels high
  dma_display->setTextWrap(false); // Don't wrap at end of line - will do ourselves
  dma_display->setTextColor(dma_display->color565(255, 0, 255));

  dma_display->setCursor(1, 0);    // start at top left, with 8 pixel of spacing

  dma_display->print("SPIFFS: ");
  dma_display->setCursor(48, 0);
  // Initialise SPIFFS, if this fails try .begin(true)
  if (!SPIFFS.begin() && !SPIFFS.begin(true)) {
    dma_display->print("NO!");
    Serial.println("SPIFFS initialisation failed!");
    while (1) yield(); // Stay here twiddling thumbs waiting
  } else {
    dma_display->print("OK!");
  }

  dma_display->setCursor(1, 10);    // start at top left, with 8 pixel of spacing
  dma_display->print("WiFi: ");
  dma_display->setCursor(48, 10);
  WiFi.mode(WIFI_STA);
  WiFi.begin(ssid, password);
  Serial.println("");

  // Wait for connection
  while (WiFi.status() != WL_CONNECTED) {
    delay(500);
    Serial.print(".");
  }
  Serial.println("");
  Serial.print("Connected to ");
  Serial.println(ssid);
  Serial.print("IP address: ");
  Serial.println(WiFi.localIP());

  dma_display->print("OK!");

  // this line ignores the HTTPS validation check
  // You could set a cert here instead to check the server
  // you are talking to is who you expect
  client.setInsecure();

  // Makes the example a little simpler to have a global for it in WebRequest
  webClient = &client;

}

fs::File myfile;

// Callbacks used by the jpeg library

void * myOpen(const char *filename, int32_t *size) {
  myfile = SPIFFS.open(filename);
  *size = myfile.size();
  return &myfile;
}
void myClose(void *handle) {
  if (myfile) myfile.close();
}
int32_t myRead(JPEGFILE *handle, uint8_t *buffer, int32_t length) {
  if (!myfile) return 0;
  return myfile.read(buffer, length);
}
int32_t mySeek(JPEGFILE *handle, int32_t position) {
  if (!myfile) return 0;
  return myfile.seek(position);
}

void drawImageFile(char *imageFileUri) {
  unsigned long lTime = millis();
  lTime = millis();
  jpeg.open(imageFileUri, myOpen, myClose, myRead, mySeek, JPEGDraw);
  jpeg.decode(0, 0, 0);
  jpeg.close();
  Serial.print("Time taken to decode and display Image (ms): ");
  Serial.println(millis() - lTime);
}

int displayImage(const char* image) {

  // In this example I re-use the same filename
  // over and over, but you could check does the image
  // exist and not fetch it again
  if (SPIFFS.exists(imageLocation) == true) {
    Serial.println("Removing existing image");
    SPIFFS.remove(imageLocation);
  }

  fs::File f = SPIFFS.open(imageLocation, "w+");
  if (!f) {
    Serial.println("file open failed");
    return -1;
  }

  unsigned long lTime = millis();

  bool gotImage = getImage((char *)image, &f);

  Serial.print("Time taken to get Image (ms): ");
  Serial.println(millis() - lTime);

  // Make sure to close the file!
  f.close();

  if (gotImage) {
    drawImageFile((char *)imageLocation);
    return 0;
  } else {
    return -2;
  }
}

void loop()
{

  // Fetch the jpg file from the specified URL and save in given location
  int displayImageResult = displayImage(imageUrl);

  if (displayImageResult == 0) {
    Serial.print("Image should be displayed! ");
  } else {
    Serial.print("Failed to display image: ");
    Serial.println(displayImageResult);
  }

  // Wait forever
  while (1) yield();
}`

I've struggled with this for several days and is now asking for your help. I am an experienced coder but new to the ESP32.

witnessmenow, 2023-02-08:
Hello, the jpegdec library was updated a while ago, this project here was
updated to work with it, so hopefully you can compare and see what needs to
be changed

https://github.com/witnessmenow/Spotify-NFC-Matrix-Display/blob/master/Esp32SpotifyMatrixNFC/Esp32SpotifyMatrixNFC.ino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

There is a lot more to that Spotify project, so just focus on image parts
of it!

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

Thread 20 (2023-02-25):

what is the correct pin header part?

lmurdock12, 2023-02-25:
The BOM [here](https://github.com/witnessmenow/ESP32-Trinity/blob/master/hardware/ESP32Trinity/V1.2/Trinity%20Bom%20V1.2%20-%20BOM_ESP32_TRINITY_V1_2_2021-07-05.csv) points out that the 16 pin header on the bottom side is LCSC part [C30734](https://www.lcsc.com/product-detail/Female-Headers_BOOMELE-Boom-Precision-Elec-C30734_C30734.html).
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

This part does not match the part I am seeing in the trinity pictures with the two spacer pins on each and and the notch
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

What should be the correct part number?

I see `2×8Double female header - See Note` on the BOM sheet, is this pointed out where the "note" is?

thanks!

witnessmenow, 2023-02-26:
Hey,

Well spotted actually, not something I thought about.

A double female pin header like your photo will work, but as you say, it's
not the same. The company that assemble the Trinity for me (makerfabs) were
able to source a different part that is keyed (meaning it has that little
nub) and also wider.

The downside of the regular header is it is possible to put the Trinity in
backwards (easy enough to diagnose as the printed arrows won't match up)
and it's also possible to plug it in not centered (harder to diagnose).
Neither should result in damage to the board or Trinity

The only place I found it before was AliExpress in quantities of 100, which
doesn't really make sense for a BOM, but here it is:

US $25.71 | 100pcs 2.54mm 0.1" Pitch 2x8 Pin 16 Pin Female Pin Header Strip
Polarizing Key
https://a.aliexpress.com/_msmBFjM

Hope this helps

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

Thread 21 (2023-04-09):

3.3V buffering capacitor needed

jhbruhn, 2023-04-09:
On my Trinity board I had to add an extra capacitor to the 3.3V power line for it to have a stable WiFi connection at all times. I used a 470uF one as it was the first one from the drawer, but less is probably also enough.

Maybe I accidentally used some slightly different parts to assemble my board because it apparently wasn't needed for the "originals", but I'm leaving this info here if anyone should have intermittent WiFi issues like I had.

Thanks for this great project!

jhbruhn, 2023-04-09:
Huh, it seems that does not fix my issues completely. I loose my MQTT connection after some minutes. Touching the ESP32-Casing (???) seems to restore it. I am confusion.

witnessmenow, 2023-04-09:
I haven't seen any similar issues with any of my versions, but happy to keep it open.

Without knowing much about anything, touching the esp32 casing solving it sounds like a ground issue, maybe the ground pads under the esp32 didn't flow right?

jhbruhn, 2023-04-09:
That was my thought as well, but the datasheet states that the bottom pad does not necessarily have to be soldered.

I switched to a different WiFi AP (was tplink EAP 653, now a FritzBox) and it seems to be stable now, so I think I can blame the WiFi network for my issues. I will need to watch it further but am pretty certain that this was the actual issue.

Thread 22 (2023-05-13):

Trouble using the ESP32 Trinity with certain LED Matrix

lohant, 2023-05-13:
I am using the ESP32 Trinity and this library together: https://github.com/mrfaptastic/ESP32-HUB75-MatrixPanel-DMA

I have multiple files (including provided example files) that are working fine on one of my 64x64 led matrixes, but the new 64x64 matrices I received yesterday does not work with that code. I am using the same ESP32 Trinity to run the code in both cases. I received five identical matrices yesterday and none works so it is highly unlikely that the problem is with the hardware.

These are the matrices that does not work: https://www.alibaba.com/product-detail/Led-Video-Wall-Led-Advertising-Module_62222559088.html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

I suspect that the error is with the driver of the IC. It says that it uses the ICN2038S chip on the specification but from what I can see on the ICs themselves they say "TC7262". I have tried the PatternPlasma example as well as tried all the different driver configurations (mxconfig.driver = HUB75_I2S_CFG::ICN2038S; etc) but with no success.

On the HUB75 contact there is a difference between the panels, the new ones got a pin "D" where the old one is marked "GND".

I am not sure what to try next and would be very grateful for any help or suggestions I could get!

Thread 24 (2023-08-03):

'uint8_t' does not name a type error

hamza3e, 2023-08-03:
In examples/BuildingBlocks/Images/DisplayGIF/DisplayGIF.ino, it is needed to include <Arduino.h> to avoid this error

Thread 25 (2023-08-04):

Barrel jack size

laserir, 2023-08-04:
Hi, PSUs seem to have more likely 5,5x**2,5** (instead of 5,5x**2,1**) connectors. Before purchasing... will these fit as well?

witnessmenow, 2023-08-04:
The spec is the 2.1mm. 2.5mm ones will physically fit but it might not make a good connection

Closed 2023-08-14.

Thread 26 (2023-08-14):

Power Output

laserir, 2023-08-14:
Hi, I power the board with 5V 3A over USB. The output voltage (that is supposed to power the display) only reaches 1,6V. Am I missing something?

witnessmenow, 2023-08-14:
Have you enabled the jumper for USB power?

"Powering the matrix panel using USB-C" section of this page

https://esp32trinity.com/setup.html

witnessmenow, 2023-08-14:
What type of display are you trying to power or how many displays? What voltage do you see when there is no displays attached?

laserir, 2023-08-14:
Believe it or not... faulty USB cable... so stupid, sorry to bother :D

Closed 2023-08-14.

Thread 28 (2024-06-25):

Ideas to fix ESP32-Trinity to rear of RGB matrix panel?

Jimbo99, 2024-06-25:
I'm using an ESP32-Trinity board with a 64x32 2.5mm pitch RGB LED matrix panel. It works brilliantly.

Just wondering if anyone has suggestions how to physically mount the ESP32-Trinity so that it does not fall out when plugged into the rear of the matrix panel? (The screw thread holes in my panel do not match any of the holes in the ESP32-Trinity board). Thanks.

Thread 29 (2025-01-20):

No Red color

Plehanov1971, 2025-01-20:
I can't figure out the reason. There is no red color. Other libraries have it.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

witnessmenow, 2025-01-20:
What do you mean by other libraries have it? Also I assume by the ribbon
cable your using hardware other than an Trinity for this?

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
