witnessmenow/ESP32-Trinity/hardware/ESP32Trinity/V1.2/Schematic_ESP32-Trinity_2021-08-27.pdf

# USB - UART

# Auto-Reset

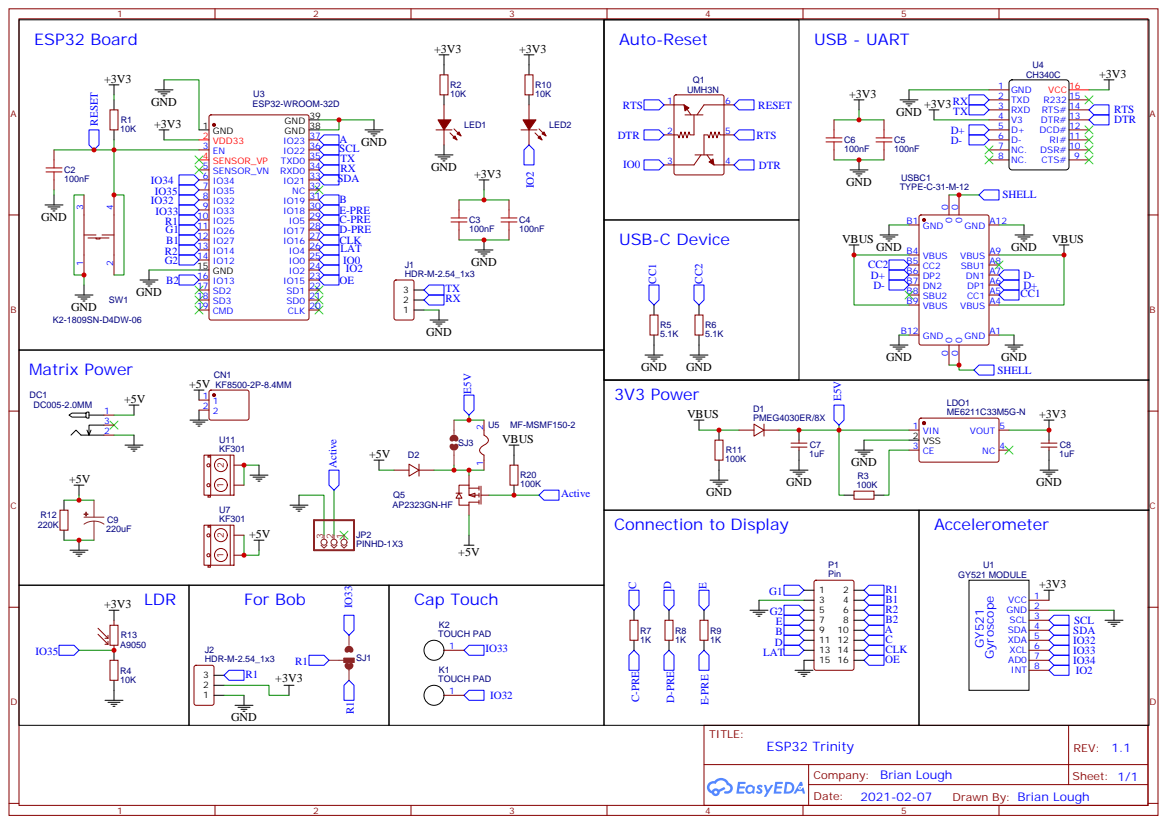
[picture p26: page 1]

Drawn By: Brian Lough
