witnessmenow/ESP32-Trinity/hardware/Add-Ons/Add-on-Breakout/Schematic_Trinity Add-On-Breakout_2021-09-19.pdf

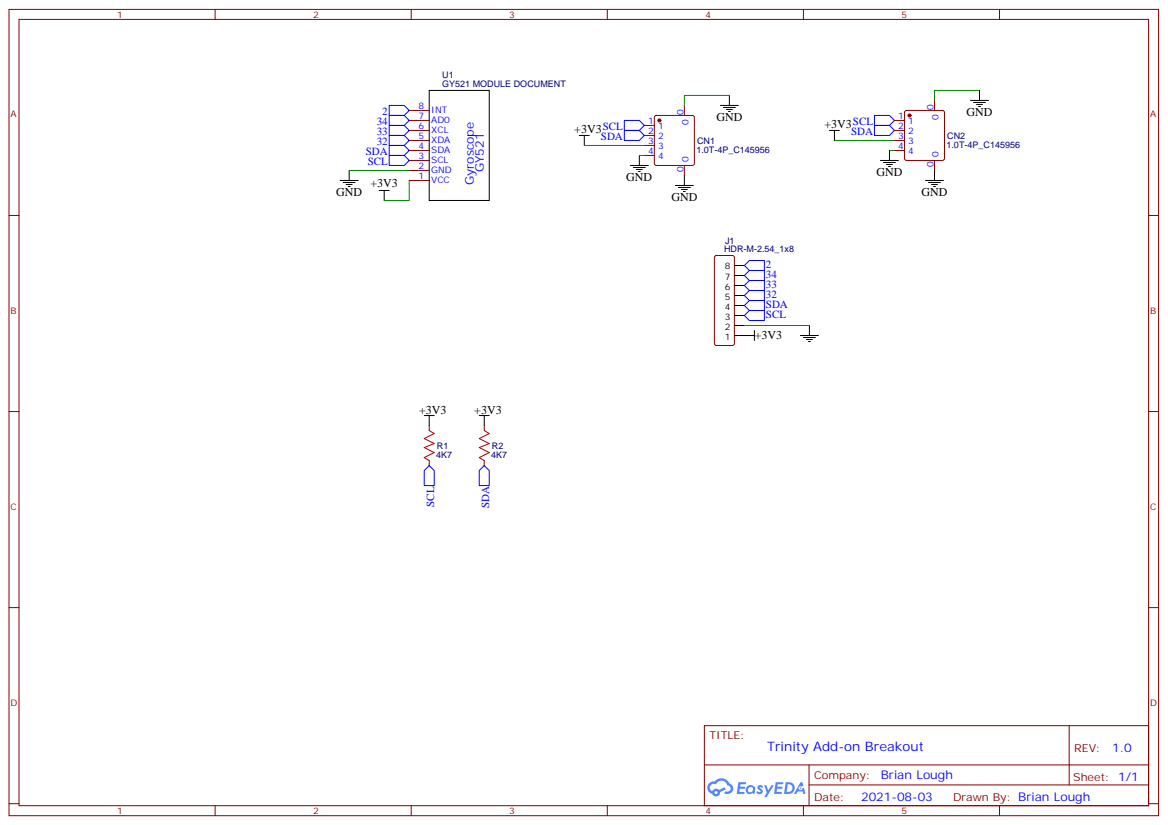
[picture p27: page 1]

Drawn By: Brian Lough
