witnessmenow/ESP32-Trinity/hardware/Add-Ons/MicroSd-board/Schematic_SD Card GY521_2021-09-19.pdf

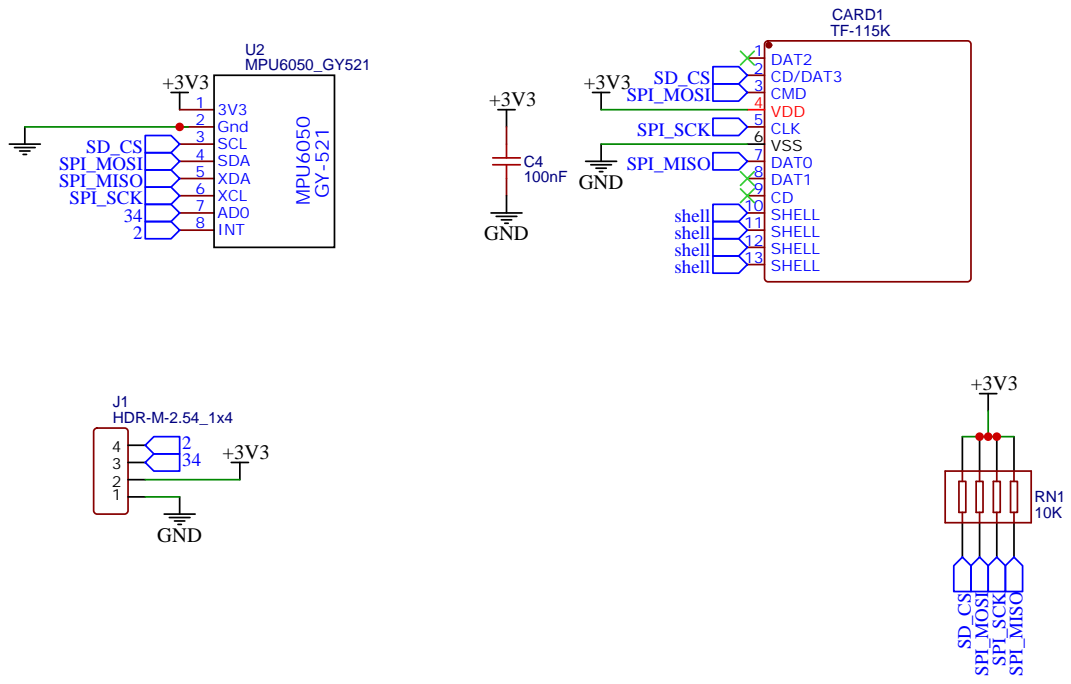
[picture p28: page 1]

Drawn By: Brian Lough
