witnessmenow/ESP32-Trinity/hardware/Add-Ons/Nunchuck-board/Nunchuck-MPU6050_2021-09-19.pdf

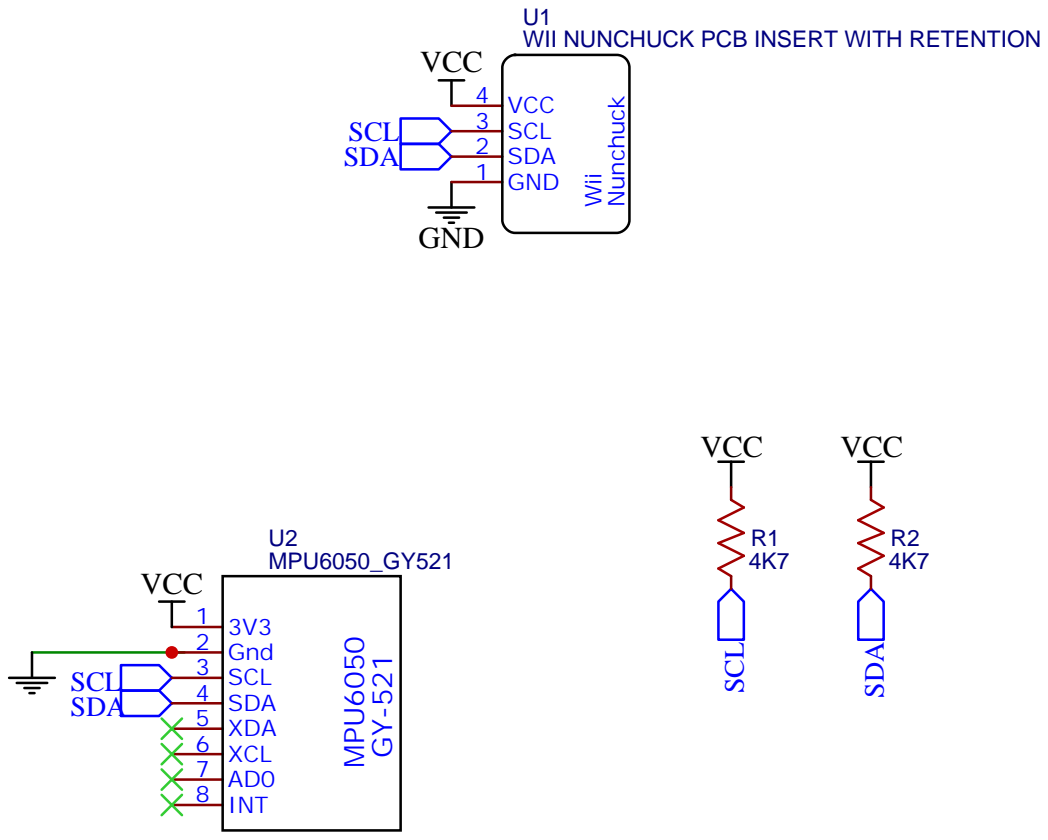
[picture p29: page 1]

Drawn By: Brian Lough
