witnessmenow/ESP32-Trinity/examples/Projects/WifiTetrisClockWifiManager/WifiTetrisClockWifiManager.ino

/*******************************************************************
    Tetris clock using a 64x32 RGB Matrix that fetches its
    time over WiFi using the EzTimeLibrary.

    For use with my I2S Matrix Shield.

    Parts Used:
    ESP32 D1 Mini * - https://s.click.aliexpress.com/e/_dSi824B
    ESP32 I2S Matrix Shield (From my Tindie) = https://www.tindie.com/products/brianlough/esp32-i2s-matrix-shield/

      = Affilate

    If you find what I do useful and would like to support me,
    please consider becoming a sponsor on Github
    https://github.com/sponsors/witnessmenow/

    Written by Brian Lough
    YouTube: https://www.youtube.com/brianlough
    Tindie: https://www.tindie.com/stores/brianlough/
    Twitter: https://twitter.com/witnessmenow
 *******************************************************************/
// ----------------------------
// Library Defines - Need to be defined before library import
// ----------------------------

#define ESP_DRD_USE_SPIFFS      true

// ----------------------------
// Standard Libraries - Already Installed if you have ESP32 set up
// ----------------------------

#include <WiFi.h>
#include <FS.h>
#include <SPIFFS.h>

// ----------------------------
// Additional Libraries - each one of these will need to be installed.
// ----------------------------

#include <WiFiManager.h>
// Captive portal for configuring the WiFi

// NOTE!!!!
// At time of writing this is broken with ESP32 core 2.0, so either use an older Arduino core or use
// the ESP32-S2 branch of WifiManager from Github
// If installing from the library manager (Search for "WifiManager", install the Alhpa version)
// https://github.com/tzapu/WiFiManager

#include <ESP_DoubleResetDetector.h>
// A library for checking if the reset button has been pressed twice
// Can be used to enable config mode
// Can be installed from the library manager (Search for "ESP_DoubleResetDetector")
//https://github.com/khoih-prog/ESP_DoubleResetDetector

#include <ESP32-HUB75-MatrixPanel-I2S-DMA.h>
// This is the library for interfacing with the display

// Can be installed from the library manager (Search for "ESP32 MATRIX DMA")
// https://github.com/mrfaptastic/ESP32-HUB75-MatrixPanel-I2S-DMA

#include <TetrisMatrixDraw.h>
// This library draws out characters using a tetris block
// amimation
// Can be installed from the library manager
// https://github.com/toblum/TetrisAnimation

#include <ezTime.h>
// Library used for getting the time and adjusting for DST
// Search for "ezTime" in the Arduino Library manager
// https://github.com/ropg/ezTime

#include <ArduinoJson.h>
// ArduinoJson is used for parsing and creating the config file.
// Search for "Arduino Json" in the Arduino Library manager
// https://github.com/bblanchon/ArduinoJson

// ----------------------------
// Dependency Libraries - each one of these will need to be installed.
// ----------------------------

// Adafruit GFX library is a dependancy for the matrix Library
// Can be installed from the library manager
// https://github.com/adafruit/Adafruit-GFX-Library


// -------------------------------------
// ------- Replace the following! ------
// -------------------------------------

// Wifi network station credentials
char ssid[] = "SSID";     // your network SSID (name)
char password[] = "password"; // your network key

// Set a timezone using the following list
// https://en.wikipedia.org/wiki/List_of_tz_database_time_zones
#define MYTIMEZONE "Europe/Dublin"

// -------------------------------------
// -------   Matrix Config   ------
// -------------------------------------

const int panelResX = 64;   // Number of pixels wide of each INDIVIDUAL panel module.
const int panelResY = 32;   // Number of pixels tall of each INDIVIDUAL panel module.
const int panel_chain = 1;  // Total number of panels chained one to another.

// -------------------------------------
// -------   Clock Config   ------
// -------------------------------------

// Sets whether the clock should be 12 hour format or not.
bool twelveHourFormat = true;

// If this is set to false, the number will only change if the value behind it changes
// e.g. the digit representing the least significant minute will be replaced every minute,
// but the most significant number will only be replaced every 10 minutes.
// When true, all digits will be replaced every minute.
bool forceRefresh = true;

// -------------------------------------
// -------   Other Config   ------
// -------------------------------------

const int PIN_LED       = 2;

#define TETRIS_CONFIG_JSON "/tetris_config.json"

// Number of seconds after reset during which a
// subseqent reset will be considered a double reset.
#define DRD_TIMEOUT 10

// RTC Memory Address for the DoubleResetDetector to use
#define DRD_ADDRESS 0

// -----------------------------

// -----------------------------

MatrixPanel_I2S_DMA *dma_display = nullptr;
DoubleResetDetector* drd;

portMUX_TYPE timerMux = portMUX_INITIALIZER_UNLOCKED;
hw_timer_t * animationTimer = NULL;

unsigned long animationDue = 0;
int animationDelay = 100; // Smaller number == faster

uint16_t myBLACK = dma_display->color565(0, 0, 0);

TetrisMatrixDraw tetris(*dma_display); // Main clock
TetrisMatrixDraw tetris2(*dma_display); // The "M" of AM/PM
TetrisMatrixDraw tetris3(*dma_display); // The "P" or "A" of AM/PM

Timezone myTZ;
unsigned long oneSecondLoopDue = 0;

bool showColon = true;
volatile bool finishedAnimating = false;
bool displayIntro = true;

String lastDisplayedTime = "";
String lastDisplayedAmPm = "";

//flag for saving data
bool shouldSaveConfig = false;

#define TIME_ZONE_LEN 100

#define TIME_ZONE_LABEL "mytimezone"
#define MATRIX_CLK_LABEL "clk"
#define MATRIX_DRIVER_LABEL "driver"
#define MATRIX_64_LABEL "is64"
#define TIME_24H_LABEL "is24h"
#define TIME_FORCE_LABEL "isForce"
#define TIME_ANIMATION_DELAY_LABEL "delay"

char timeZone[TIME_ZONE_LEN] = MYTIMEZONE;
bool matrixClk = false;
bool matrixDriver = false;
bool matrixIs64 = false;

int y_offset = panelResY / 2;

// This method is for controlling the tetris library draw calls
void animationHandler()
{
  // Not clearing the display and redrawing it when you
  // dont need to improves how the refresh rate appears
  if (!finishedAnimating) {
    dma_display->fillScreen(myBLACK);
    if (displayIntro) {
      finishedAnimating = tetris.drawText(1, 5 + y_offset);
    } else {
      if (twelveHourFormat) {
        // Place holders for checking are any of the tetris objects
        // currently still animating.
        bool tetris1Done = false;
        bool tetris2Done = false;
        bool tetris3Done = false;

        tetris1Done = tetris.drawNumbers(-6, 10 + y_offset, showColon);
        tetris2Done = tetris2.drawText(56, 9 + y_offset);

        // Only draw the top letter once the bottom letter is finished.
        if (tetris2Done) {
          tetris3Done = tetris3.drawText(56, -1 + y_offset);
        }

        finishedAnimating = tetris1Done && tetris2Done && tetris3Done;

      } else {
        finishedAnimating = tetris.drawNumbers(2, 10 + y_offset, showColon);
      }
    }
    dma_display->flipDMABuffer();
  }

}

void drawIntro(int x = 0, int y = 0)
{
  dma_display->fillScreen(myBLACK);
  tetris.drawChar("P", x, y, tetris.tetrisCYAN);
  tetris.drawChar("o", x + 5, y, tetris.tetrisMAGENTA);
  tetris.drawChar("w", x + 11, y, tetris.tetrisYELLOW);
  tetris.drawChar("e", x + 17, y, tetris.tetrisGREEN);
  tetris.drawChar("r", x + 22, y, tetris.tetrisBLUE);
  tetris.drawChar("e", x + 27, y, tetris.tetrisRED);
  tetris.drawChar("d", x + 32, y, tetris.tetrisWHITE);
  tetris.drawChar(" ", x + 37, y, tetris.tetrisMAGENTA);
  tetris.drawChar("b", x + 42, y, tetris.tetrisYELLOW);
  tetris.drawChar("y", x + 47, y, tetris.tetrisGREEN);
  dma_display->flipDMABuffer();
}

void drawConnecting(int x = 0, int y = 0)
{
  dma_display->fillScreen(myBLACK);
  tetris.drawChar("C", x, y, tetris.tetrisCYAN);
  tetris.drawChar("o", x + 5, y, tetris.tetrisMAGENTA);
  tetris.drawChar("n", x + 11, y, tetris.tetrisYELLOW);
  tetris.drawChar("n", x + 17, y, tetris.tetrisGREEN);
  tetris.drawChar("e", x + 22, y, tetris.tetrisBLUE);
  tetris.drawChar("c", x + 27, y, tetris.tetrisRED);
  tetris.drawChar("t", x + 32, y, tetris.tetrisWHITE);
  tetris.drawChar("i", x + 37, y, tetris.tetrisMAGENTA);
  tetris.drawChar("n", x + 42, y, tetris.tetrisYELLOW);
  tetris.drawChar("g", x + 47, y, tetris.tetrisGREEN);
  dma_display->flipDMABuffer();
}

//callback notifying us of the need to save config
void saveConfigCallback () {
  Serial.println("Should save config");
  shouldSaveConfig = true;
}

void configModeCallback (WiFiManager *myWiFiManager) {
  Serial.println("Entered Conf Mode");
  dma_display->fillScreen(myBLACK);
  dma_display->setTextSize(1);     // size 1 == 8 pixels high
  dma_display->setTextWrap(false);
  dma_display->setTextColor(tetris.tetrisBLUE);
  dma_display->setCursor(0, 0);
  dma_display->print(myWiFiManager->getConfigPortalSSID());

  dma_display->setTextWrap(true);
  dma_display->setTextColor(tetris.tetrisRED);
  dma_display->setCursor(0, 8);
  dma_display->print(WiFi.softAPIP());

  dma_display->flipDMABuffer();
}

void saveConfigFile() {
  Serial.println(F("Saving config"));
  StaticJsonDocument<512> json;
  json[TIME_ZONE_LABEL] = timeZone;
  json[TIME_24H_LABEL] = !twelveHourFormat;
  json[TIME_FORCE_LABEL] = forceRefresh;
  json[TIME_ANIMATION_DELAY_LABEL] = animationDelay;

  JsonObject matrixJson = json.createNestedObject("matrix");
  matrixJson[MATRIX_CLK_LABEL] = matrixClk;
  matrixJson[MATRIX_DRIVER_LABEL] = matrixDriver;
  matrixJson[MATRIX_64_LABEL] = matrixIs64;

  File configFile = SPIFFS.open(TETRIS_CONFIG_JSON, "w");
  if (!configFile) {
    Serial.println("failed to open config file for writing");
  }

  serializeJsonPretty(json, Serial);
  if (serializeJson(json, configFile) == 0) {
    Serial.println(F("Failed to write to file"));
  }
  configFile.close();
}

bool setupSpiffs() {
  //clean FS, for testing
  // SPIFFS.format();

  //read configuration from FS json
  Serial.println("mounting FS...");

  // May need to make it begin(true) first time you are using SPIFFS
  if (SPIFFS.begin(false) || SPIFFS.begin(true)) {
    Serial.println("mounted file system");
    if (SPIFFS.exists(TETRIS_CONFIG_JSON)) {
      //file exists, reading and loading
      Serial.println("reading config file");
      File configFile = SPIFFS.open("/tetris_config.json", "r");
      if (configFile) {
        Serial.println("opened config file");
        StaticJsonDocument<512> json;
        DeserializationError error = deserializeJson(json, configFile);
        serializeJsonPretty(json, Serial);
        if (!error) {
          Serial.println("\nparsed json");

          strcpy(timeZone, json[TIME_ZONE_LABEL]);
          twelveHourFormat = !json[TIME_24H_LABEL].as<bool>();
          forceRefresh = json[TIME_FORCE_LABEL].as<bool>();
          animationDelay = json[TIME_ANIMATION_DELAY_LABEL].as<int>();

          matrixClk = json["matrix"][MATRIX_CLK_LABEL].as<bool>();
          matrixDriver = json["matrix"][MATRIX_DRIVER_LABEL].as<bool>();
          matrixIs64 = json["matrix"][MATRIX_64_LABEL].as<bool>();


          return true;

        } else {
          Serial.println("failed to load json config");
        }
      }
    }
  } else {
    Serial.println("failed to mount FS");
  }
  //end read
  return false;
}

void configDisplay() {
  HUB75_I2S_CFG mxconfig(
    panelResX,   // Module width
    panelResY,   // Module height
    panel_chain  // Chain length
  );

  if (matrixIs64) {
    mxconfig.mx_height = 64;
    y_offset = 32;
  }


  mxconfig.double_buff = true;
  mxconfig.gpio.e = 18;

  // May or may not be needed depending on your matrix
  // Example of what needing it looks like:
  // https://github.com/mrfaptastic/ESP32-HUB75-MatrixPanel-I2S-DMA/issues/134#issuecomment-866367216
  mxconfig.clkphase = false;

  //mxconfig.driver = HUB75_I2S_CFG::FM6126A;

  // Display Setup
  dma_display = new MatrixPanel_I2S_DMA(mxconfig);
  dma_display->begin();
  dma_display->fillScreen(myBLACK);
}

void setup() {
  Serial.begin(115200);
  pinMode(PIN_LED, OUTPUT);

  bool forceConfig = false;

  drd = new DoubleResetDetector(DRD_TIMEOUT, DRD_ADDRESS);
  if (drd->detectDoubleReset()) {
    Serial.println(F("Forcing config mode as there was a Double reset detected"));
    forceConfig = true;
  }

  bool spiffsSetup = setupSpiffs();
  if (!spiffsSetup) {
    Serial.println(F("Forcing config mode as there is no saved config"));
    forceConfig = true;
  }

  configDisplay();

  dma_display->setTextSize(1);     // size 1 == 8 pixels high
  dma_display->setTextColor(tetris.tetrisBLUE);
  dma_display->setCursor(0, 0);
  if (!forceConfig) {
    dma_display->print("Booting");
  } else {
    dma_display->print("Conf Mode");
  }
  dma_display->flipDMABuffer();



  WiFiManager wm;
  //set config save notify callback
  wm.setSaveConfigCallback(saveConfigCallback);
  //set callback that gets called when connecting to previous WiFi fails, and enters Access Point mode
  wm.setAPCallback(configModeCallback);


  WiFiManagerParameter custom_time_zone(TIME_ZONE_LABEL, "Time Zone", timeZone, TIME_ZONE_LEN);

  char checkBox[] = "type=\"checkbox\"";
  char checkBoxChecked[] = "type=\"checkbox\" checked";
  char* customHtml;

  if (!twelveHourFormat) {
    customHtml = checkBoxChecked;
  } else {
    customHtml = checkBox;
  }
  WiFiManagerParameter custom_time_24h(TIME_24H_LABEL, "24 hour Clock", "T", 2, customHtml);

  if (forceRefresh) {
    customHtml = checkBoxChecked;
  } else {
    customHtml = checkBox;
  }
  WiFiManagerParameter custom_time_force(TIME_FORCE_LABEL, "Force every digit reset", "T", 2, customHtml);


  char convertedValue[6];
  sprintf(convertedValue, "%d", animationDelay);

  WiFiManagerParameter custom_time_delay(TIME_ANIMATION_DELAY_LABEL, "Animation Delay (smaller == faster)", convertedValue, 7);

  if (matrixClk) {
    customHtml = checkBoxChecked;
  } else {
    customHtml = checkBox;
  }
  WiFiManagerParameter custom_clk(MATRIX_CLK_LABEL, "Set clkphase false", "T", 2, customHtml);

  if (matrixDriver) {
    customHtml = checkBoxChecked;
  } else {
    customHtml = checkBox;
  }
  WiFiManagerParameter custom_driver(MATRIX_DRIVER_LABEL, "Set Driver to FM6126A", "T", 2, "type=\"checkbox\"");

  if (matrixIs64) {
    customHtml = checkBoxChecked;
  } else {
    customHtml = checkBox;
  }
  WiFiManagerParameter custom_is64(MATRIX_64_LABEL, "64x64 panel", "T", 2, "type=\"checkbox\"");

  //add all your parameters here
  wm.addParameter(&custom_time_zone);
  wm.addParameter(&custom_time_24h);
  wm.addParameter(&custom_time_force);
  wm.addParameter(&custom_time_delay);
  wm.addParameter(&custom_clk);
  wm.addParameter(&custom_driver);
  wm.addParameter(&custom_is64);

  digitalWrite(PIN_LED, LOW);
  if (forceConfig) {
    if (!wm.startConfigPortal("WifiTetris", "clock123")) {
      Serial.println("failed to connect and hit timeout");
      delay(3000);
      //reset and try again, or maybe put it to deep sleep
      ESP.restart();
      delay(5000);
    }
  } else {
    if (!wm.autoConnect("WifiTetris", "clock123")) {
      Serial.println("failed to connect and hit timeout");
      delay(3000);
      // if we still have not connected restart and try all over again
      ESP.restart();
      delay(5000);
    }
  }

  //save the custom parameters to FS
  if (shouldSaveConfig)
  {

    strncpy(timeZone, custom_time_zone.getValue(), sizeof(timeZone));
    matrixClk = (strncmp(custom_clk.getValue(), "T", 1) == 0);
    matrixDriver = (strncmp(custom_driver.getValue(), "T", 1) == 0);
    matrixIs64 = (strncmp(custom_is64.getValue(), "T", 1) == 0);

    twelveHourFormat = !(strncmp(custom_time_24h.getValue(), "T", 1) == 0);
    forceRefresh = (strncmp(custom_time_force.getValue(), "T", 1) == 0);
    animationDelay = atoi(custom_time_delay.getValue());

    saveConfigFile();
    drd->stop();
    ESP.restart();
    delay(5000);
  }

  digitalWrite(PIN_LED, HIGH);

  tetris.display = dma_display; // Main clock
  tetris2.display = dma_display; // The "M" of AM/PM
  tetris3.display = dma_display; // The "P" or "A" of AM/PM

  if (WiFi.status() == WL_CONNECTED)
  {
    Serial.print(F("connected. Local IP: "));
    Serial.println(WiFi.localIP());
  }

  // "connecting"
  drawConnecting(5, -6 + y_offset);

  // Setup EZ Time
  //setDebug(INFO);
  waitForSync();

  Serial.println();
  Serial.println("UTC:             " + UTC.dateTime());

  myTZ.setLocation(timeZone);
  Serial.print(F("Time in your set timezone:         "));
  Serial.println(myTZ.dateTime());

  // "Powered By"
  drawIntro(6, -4 + y_offset);
  delay(2000);

  // Start the Animation Timer
  tetris.setText("TRINITY");

  // Wait for the animation to finish
  while (!finishedAnimating)
  {
    delay(animationDelay);
    animationHandler();
  }
  delay(2000);
  finishedAnimating = false;
  displayIntro = false;
  tetris.scale = 2;
  //tetris.setTime("00:00", true);
}

void setMatrixTime() {
  String timeString = "";
  String AmPmString = "";
  if (twelveHourFormat) {
    // Get the time in format "1:15" or 11:15 (12 hour, no leading 0)
    // Check the EZTime Github page for info on
    // time formatting
    timeString = myTZ.dateTime("g:i");

    //If the length is only 4, pad it with
    // a space at the beginning
    if (timeString.length() == 4) {
      timeString = " " + timeString;
    }

    //Get if its "AM" or "PM"
    AmPmString = myTZ.dateTime("A");
    if (lastDisplayedAmPm != AmPmString) {
      Serial.println(AmPmString);
      lastDisplayedAmPm = AmPmString;
      // Second character is always "M"
      // so need to parse it out
      tetris2.setText("M", forceRefresh);

      // Parse out first letter of String
      tetris3.setText(AmPmString.substring(0, 1), forceRefresh);
    }
  } else {
    // Get time in format "01:15" or "22:15"(24 hour with leading 0)
    timeString = myTZ.dateTime("H:i");
  }

  // Only update Time if its different
  if (lastDisplayedTime != timeString) {
    Serial.println(timeString);
    lastDisplayedTime = timeString;
    tetris.setTime(timeString, forceRefresh);

    // Must set this to false so animation knows
    // to start again
    finishedAnimating = false;
  }
}

void handleColonAfterAnimation() {

  // It will draw the colon every time, but when the colour is black it
  // should look like its clearing it.
  uint16_t colour =  showColon ? tetris.tetrisWHITE : tetris.tetrisBLACK;
  // The x position that you draw the tetris animation object
  int x = twelveHourFormat ? -6 : 2;
  // The y position adjusted for where the blocks will fall from
  // (this could be better!)
  int y = 10 + y_offset - (TETRIS_Y_DROP_DEFAULT * tetris.scale);
  tetris.drawColon(x, y, colour);
  dma_display->flipDMABuffer();
}


void loop() {
  drd->loop();
  unsigned long now = millis();
  if (now > oneSecondLoopDue) {
    // We can call this often, but it will only
    // update when it needs to
    setMatrixTime();
    showColon = !showColon;

    // To reduce flicker on the screen we stop clearing the screen
    // when the animation is finished, but we still need the colon to
    // to blink
    if (finishedAnimating) {
      handleColonAfterAnimation();
    }
    oneSecondLoopDue = now + 1000;
  }
  now = millis();
  if (now > animationDue) {
    animationHandler();
    animationDue = now + animationDelay;
  }
}
