witnessmenow/ESP32-Trinity/examples/BuildingBlocks/Images/DisplayGIF/ThisIsFine.h

//
// ThisIsFine64
// Data size = 17079 bytes
//
// GIF, Compression=LZW, Size: 64 x 64, 8-Bpp
// 3 frames
//
// for non-Arduino builds...
#ifndef PROGMEM
#define PROGMEM
#endif
const uint8_t ThisIsFine64[] PROGMEM = {
  0x47,0x49,0x46,0x38,0x39,0x61,0x40,0x00,0x40,0x00,0xf7,0x00,0x00,0x0e,0x09,0x00,
  0x0e,0x04,0x00,0x04,0x06,0x00,0x12,0x06,0x00,0x15,0x0a,0x00,0x1a,0x0c,0x00,0x0e,
  0x12,0x00,0x14,0x11,0x00,0x1c,0x13,0x00,0x1d,0x19,0x00,0x23,0x14,0x00,0x2b,0x15,
  0x00,0x23,0x1d,0x00,0x2b,0x1d,0x00,0x33,0x1b,0x00,0x33,0x17,0x00,0x25,0x0e,0x00,
  0x25,0x20,0x00,0x2c,0x22,0x02,0x35,0x23,0x00,0x3b,0x23,0x01,0x3e,0x2c,0x00,0x36,
  0x2b,0x07,0x3d,0x34,0x09,0x3c,0x34,0x15,0x49,0x1e,0x00,0x44,0x2b,0x00,0x4b,0x2c,
  0x00,0x44,0x24,0x02,0x57,0x2b,0x02,0x45,0x33,0x00,0x4b,0x33,0x01,0x4d,0x3b,0x00,
  0x45,0x38,0x07,0x53,0x34,0x02,0x55,0x3b,0x00,0x5b,0x3a,0x01,0x5a,0x38,0x05,0x47,
  0x3c,0x19,0x68,0x2c,0x00,0x62,0x3b,0x00,0x68,0x38,0x02,0x77,0x37,0x01,0x74,0x2e,
  0x00,0x54,0x43,0x00,0x5c,0x43,0x00,0x58,0x49,0x04,0x54,0x48,0x1e,0x57,0x49,0x0c,
  0x64,0x4b,0x01,0x6c,0x4c,0x01,0x69,0x45,0x03,0x7a,0x4b,0x01,0x77,0x47,0x02,0x6c,
  0x53,0x02,0x68,0x56,0x02,0x71,0x54,0x01,0x75,0x5a,0x00,0x7a,0x5a,0x01,0x7a,0x53,
  0x04,0x71,0x56,0x17,0x7c,0x64,0x01,0x7b,0x67,0x04,0x78,0x65,0x14,0x69,0x59,0x26,
  0x78,0x69,0x33,0x4f,0x45,0x20,0x79,0x6e,0x48,0x88,0x3a,0x00,0x91,0x3a,0x00,0x86,
  0x49,0x01,0x83,0x52,0x02,0x88,0x59,0x02,0x93,0x5b,0x02,0x99,0x5c,0x04,0x90,0x50,
  0x06,0xa9,0x59,0x02,0xb6,0x56,0x01,0xaf,0x4b,0x00,0x84,0x6b,0x00,0x8b,0x6a,0x01,
  0x87,0x64,0x04,0x99,0x69,0x01,0x8c,0x74,0x02,0x86,0x73,0x02,0x94,0x74,0x01,0x9a,
  0x72,0x00,0x94,0x7b,0x00,0x9a,0x7b,0x00,0x88,0x69,0x16,0x8f,0x74,0x1a,0xa8,0x77,
  0x01,0xbb,0x79,0x03,0xae,0x6e,0x08,0x89,0x77,0x36,0x8a,0x73,0x27,0xc5,0x4c,0x00,
  0xda,0x57,0x00,0xe7,0x5b,0x00,0xf4,0x5f,0x00,0xd9,0x67,0x01,0xc7,0x75,0x03,0xda,
  0x7a,0x03,0xc5,0x6d,0x03,0xe8,0x68,0x01,0xff,0x63,0x00,0xff,0x6b,0x01,0xff,0x72,
  0x02,0xff,0x7d,0x02,0xfe,0x7c,0x0b,0xe4,0x7a,0x02,0x88,0x7a,0x49,0x8e,0x7c,0x4c,
  0x99,0x84,0x03,0x97,0x84,0x09,0xa4,0x83,0x00,0xa4,0x8c,0x00,0xaa,0x8b,0x00,0xac,
  0x84,0x00,0xb3,0x8c,0x00,0xba,0x85,0x00,0xac,0x96,0x03,0xb4,0x93,0x00,0xbb,0x94,
  0x00,0xbd,0x9a,0x00,0xb7,0x99,0x00,0xaa,0x8a,0x1a,0xb5,0x8f,0x19,0xbe,0xa7,0x00,
  0xb2,0x97,0x2e,0xba,0xa2,0x38,0xc4,0x8b,0x01,0xc7,0x87,0x01,0xd8,0x86,0x04,0xcd,
  0x93,0x00,0xc3,0x9c,0x00,0xc9,0x9b,0x00,0xc2,0x93,0x00,0xdd,0x96,0x00,0xdd,0x9b,
  0x00,0xd4,0x95,0x03,0xd9,0x96,0x18,0xcd,0x96,0x13,0xe5,0x87,0x05,0xff,0x83,0x03,
  0xff,0x8c,0x02,0xfc,0x8a,0x0a,0xe0,0x9e,0x00,0xe7,0x95,0x03,0xff,0x94,0x03,0xff,
  0x9a,0x03,0xff,0x94,0x09,0xff,0x9c,0x0a,0xf4,0x92,0x06,0xfe,0x99,0x19,0xff,0x97,
  0x15,0xed,0x94,0x16,0xc3,0xa2,0x00,0xcb,0xa4,0x00,0xcd,0xac,0x00,0xc5,0xab,0x02,
  0xdd,0xa4,0x00,0xd4,0xac,0x00,0xdc,0xac,0x00,0xd3,0xa4,0x00,0xca,0xb4,0x00,0xd5,
  0xb1,0x00,0xdd,0xb4,0x00,0xde,0xbb,0x00,0xd1,0xba,0x00,0xcf,0xad,0x17,0xe2,0xa3,
  0x00,0xe2,0xac,0x00,0xe9,0xaa,0x04,0xfa,0xad,0x01,0xff,0xa2,0x0b,0xf8,0xa8,0x08,
  0xe1,0xb5,0x00,0xe2,0xbd,0x00,0xea,0xb7,0x05,0xf5,0xb2,0x04,0xff,0xa5,0x13,0xff,
  0xab,0x13,0xff,0xac,0x1b,0xfb,0xa6,0x19,0xff,0xb4,0x1b,0xff,0xb8,0x1e,0xfa,0xb3,
  0x16,0xed,0xac,0x14,0xd6,0xa9,0x25,0xdc,0xb3,0x2a,0xcc,0xa6,0x28,0xe5,0xb8,0x2b,
  0xff,0xbc,0x23,0xfb,0xb4,0x25,0xec,0xac,0x24,0xdc,0x9b,0x2c,0xdd,0xc3,0x00,0xda,
  0xc7,0x07,0xdf,0xc4,0x13,0xe5,0xc3,0x00,0xe9,0xc5,0x01,0xe5,0xca,0x00,0xea,0xcb,
  0x00,0xe8,0xc7,0x0c,0xf1,0xcb,0x03,0xed,0xd3,0x01,0xef,0xdc,0x00,0xf2,0xdc,0x00,
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
