witnessmenow/ESP32-Trinity/examples/Projects/FallingSand/pallet.h

const uint8_t PROGMEM pallet[] = {/* RGB888  R,G,B,R,G,B,R,G,B,...  */  
0x00,0x00,0x00,0x00,0x00,0x00,0x00,0x00,0x00,0x00,0x00,0x00,0x00,0x00,0x00,0x00,0x00,0x00,0x00,0x00,0x00,0x00,0x00,0x00,0x00,0x00,0x00,0x00,0x00,0x00,0x00,0x00,0x00,0x00,0x00,0x00,0x00,0x00,0x00,0x00,0x00,0x00,0x00,0x00,0x00,0x00,0x00,0x00,0x00,0x00,0x00,0x00,0x00,0x00,0x01,0x00,0x00,0x05,0x00,0x00,0x0a,0x00,0x00,0x10,0x00,0x00,0x15,0x00,0x00,0x1b,0x00,0x00,0x20,0x00,0x00,0x25,0x00,0x00,0x2b,0x00,0x00,0x31,0x00,0x00,0x36,0x00,0x00,0x3c,0x00,0x00,0x41,0x00,0x00,0x46,0x00,0x00,0x4c,0x00,0x00,0x52,0x00,0x00,0x57,0x00,0x00,0x5d,0x00,0x00,0x62,0x00,0x00,0x68,0x00,0x00,0x6d,0x00,0x00,0x73,0x00,0x00,0x79,0x00,0x00,0x7e,0x00,0x00,0x83,0x00,0x00,0x89,0x00,0x00,0x8e,0x00,0x00,0x94,0x00,0x00,0x9a,0x00,0x00,0x9f,0x00,0x00,0xa5,0x00,0x00,0xaa,0x00,0x00,0xb0,0x00,0x00,0xb5,0x00,0x00,0xbb,0x00,0x00,0xc0,0x00,0x00,0xc6,0x00,0x00,0xcb,0x00,0x00,0xd1,0x00,0x00,0xd7,0x00,0x00,0xdc,0x00,0x00,0xe1,0x00,0x00,0xe6,0x00,0x00,0xe8,0x02,0x00,0xe9,0x08,0x00,0xe9,0x0f,0x00,0xe9,0x13,0x00,0xe9,0x16,0x00,0xe9,0x1b,0x00,0xe9,0x21,0x00,0xe9,0x26,0x00,0xe9,0x2a,0x00,0xe9,0x2e,0x00,0xe9,0x32,0x00,0xe9,0x37,0x00,0xe9,0x3b,0x00,0xe9,0x3f,0x00,0xe9,0x44,0x00,0xe9,0x4a,0x00,0xe9,0x4e,0x00,0xe9,0x52,0x00,0xe9,0x56,0x00,0xe9,0x5a,0x00,0xe9,0x5d,0x00,0xe9,0x63,0x00,0xe9,0x67,0x00,0xe9,0x6b,0x00,0xe9,0x71,0x00,0xe9,0x77,0x00,0xe9,0x78,0x00,0xe9,0x7c,0x00,0xe9,0x81,0x00,0xe9,0x86,0x00,0xe9,0x8b,0x00,0xe9,0x8f,0x00,0xe9,0x93,0x00,0xe9,0x99,0x00,0xe9,0x9d,0x00,0xe9,0xa0,0x00,0xe9,0xa4,0x00,0xe9,0xaa,0x00,0xe9,0xb0,0x00,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
};
