witnessmenow/ESP32-Trinity/(commit log)

2020-07-14 Fixed a couple of typos
2020-11-17 resetting the score on restart
    [TetrisWithNunchuck.ino]
2021-06-22 Adding SCL and SDA, as that is what they are labeled on the PCB
2021-09-19 Overhaul of trinity repo and documentation
    [BOM_ESP32_TRINITY_V1_2_2021-07-05.csv, BOM_Nunchuck-MPU6050_2021-09-19.csv, BOM_PCB_SD Card GY521_2021-07-08.csv, BOM_Trinity Add-On-Breakout_2021-09-19.csv, Trinity Bom V1.2 - BOM_ESP32_TRINITY_V1_2_2021-07-05.csv, Trinity_V1_2_PNP_2021-08-06.csv, Trinity_V1_2_PNP_MIRROR_2021-08-06.csv]
2021-09-25 Updating setup.md with more info about USB-C power
2021-10-13 Fixing issue with sand not falling below half way
    Also updating for double buffer to work with the latest library
    [FallingSand.ino]
2021-10-15 Fixing issue with timezone in Wifimanager tetris clock
    updating both tetris clock to newest matrix library support
    [WifiTetrisClock.ino, WifiTetrisClockWifiManager.ino]
2021-10-15 Upgrade SnakeWithNunchuck matrix panel driver
2021-10-15 Upgrade TetrisWithNunchuck matrix panel driver
2021-10-15 Fixing WifiTetrisClock with wifi manager
    [WifiTetrisClockWifiManager.ino]
2021-10-30 Fixing some issues around reloading configs
    [WifiTetrisClockWifiManager.ino]
2021-11-27 Fixing issue with Printing of region
    [ESPCamMotionDetection.ino]
2023-12-21 Fixed JPEGDraw, incorrect return type for open in JPEGDEC.h.
    [DisplayImageFromWeb.ino]
2024-02-03 Adding V2 files and Logic Level Shifter files
    [BOM_ESP32-Trinity_2024-02-03.csv, BOM_Hub75-Level-shifter_2024-02-03.csv, PickAndPlace_PCB_LEvel-Shift_2_2024-02-03.csv, PickAndPlace_V2-TRinity-4-Layer-Before-Moving-UART_2024-02-03.csv]
